tan0607/avionics-ground-station/shared/protocol/PROTOCOL.md

# Telemetry Packet Protocol

> **NOT CURRENTLY FLOWN.** The live downlink is ASCII MRCC text, decoded by
> `mrcc.py`; the firmware that speaks this binary format was removed from
> `firmware/` (see that README). This spec survives because `packet.Telemetry`
> is still the project's internal data shape — `mrcc.py` maps MRCC *onto* it, so
> loss tracking, `telemetry.csv`, the WebSocket and the dashboard all keep
> consuming one shape. Read the field table as the definition of that shape.
>
> The framing, CRC and C struct below describe a wire format nothing on either
> end currently produces or parses. They are kept for the day the binary link is
> revived, not as a description of today's hardware.
>
> `packet.py` is the source of truth; this document mirrors it in human-readable
> form. Little-endian throughout.

## Framing

Every packet is a fixed **32 bytes**:

```
+--------+--------------------+-----------+
| SYNC   | BODY               | CRC16     |
| 2 B    | 28 B               | 2 B (LE)  |
| AA 55  | (fields below)     |           |
+--------+--------------------+-----------+
  0    1  2 ................ 29  30     31
```

- **SYNC** = the two literal bytes `0xAA 0x55` (that order on the wire). Marks packet boundaries in a byte stream.
- **BODY** = 28 bytes of fields (table below).
- **CRC16** = CRC-16/CCITT-FALSE over the 28 BODY bytes only (offsets 2..29), stored little-endian.

Rate: 4 Hz nominal (~128 B/s), on a bare SX1278 at SF7 / BW 125 kHz / CR 4-5
(~72 ms on air per frame) — the settings the removed binary firmware used. The
link that actually flies runs at BW 250 kHz with hardware CRC on and carries a
52-67 byte MRCC binary frame at 10 Hz, which the ground station expands into the
ASCII `shared/protocol/mrcc.py` parses; see `firmware/README.md` for the current
parameters. That frame is NOT the format below — it is a different layout with
its own field table, specified in `MRCC_FlightComputer_A/src/Config.h`. Either
way the radio is a transport detail and does not affect the bytes below.

## Field table (BODY — offsets are relative to frame start)

| Off | Size | Field | Type | Units / scaling |
|----:|-----:|---|---|---|
| 2 | 1 | msg_type | u8 | 0 = telemetry (1/2 reserved: phase-2 command/ack)  |
| 3 | 2 | seq | u16  | +1 per packet, wraps at 65535 → drives loss rate |
| 5 | 1 | flight_state | u8 | enum (below) |
| 6 | 4 | onboard_ms | u32  | ms since flight-computer boot |
| 10  | 2 | baro_alt_m | i16  | barometric altitude, m AGL |
| 12  | 2 | vspeed_dms | i16  | vertical speed, dm/s (÷10 = m/s) |
| 14  | 4 | gps_lat | i32  | latitude, degrees × 1e7 |
| 18  | 4 | gps_lon | i32  | longitude, degrees × 1e7 |
| 22  | 2 | gps_alt_m | i16  | GPS altitude, m MSL |
| 24  | 1 | gps_sats | u8 | satellites used |
| 25  | 1 | gps_fix | u8 | 0 none / 2 = 2D / 3 = 3D |
| 26  | 1 | tilt_deg | u8 | tilt from vertical, 0..180° |
| 27  | 1 | vbat_dv | u8 | battery volts × 10 (÷10 = V) |
| 28  | 1 | flags | u8 | bitfield (below) |
| 29  | 1 | health | u8 | per-peripheral health bitfield (below) |
| 30  | 2 | crc16 | u16  | CRC-16/CCITT-FALSE over bytes 2..29 |

Python `struct` format (little-endian, no padding): BODY = `<BHBIhhiihBBBBBB` (28 bytes).

## Enums

**flight_state**

| Value | Name | Meaning |
|---:|---|---|
| 0 | PAD | on the pad, pre-launch |
| 1 | BOOST  | motor burning |
| 2 | COAST  | unpowered ascent |
| 3 | APOGEE | peak altitude |
| 4 | DROGUE | descent under drogue |
| 5 | MAIN | descent under main chute |
| 6 | LANDED | on the ground |
| 7 | ARMED  | on the pad, pyro armed |

`ARMED` is **7 and not 1** because 0–6 were already on the wire, in every
`telemetry.csv` on disk and in the PLDR notebook. Inserting it chronologically
would have silently reinterpreted every recorded flight. Chronological order is
a display concern — the dashboard's timeline carries its own.

It was missing entirely until 2026-09-04, and the cost was not a missing label:
an unmapped phase word falls back to `PAD`, so an armed vehicle reported itself
as sitting safe on the pad with its pyro bus live. `backend/tests.py` now reads
`Flight.cpp`'s `stateName()` and fails if any word it can return is unmapped.

**gps_fix**: 0 = no fix, 2 = 2D, 3 = 3D.

## flags (u8 bitfield)

| Bit | Mask | Name | Meaning |
|----:|-----:|---|---|
| 0 | 0x01 | CONTINUITY | e-match continuity OK |
| 1 | 0x02 | PYRO_FIRED | a pyro channel has fired |
| 2 | 0x04 | SD_OK | onboard SD logging healthy |
| 3 | 0x08 | ARMED | flight computer armed |
| 4–7 | — | reserved | 0 |

## health (u8 bitfield)

Bit **set** = that peripheral initialised and is currently responding.
Bit **clear** = it is not, and every field it feeds is untrustworthy.

| Bit | Mask | Name | Feeds |
|----:|-----:|---|---|
| 0 | 0x01 | BARO | `baro_alt_m`, `vspeed_dms` |
| 1 | 0x02 | IMU  | `tilt_deg` |
| 2 | 0x04 | GPS  | `gps_*` |
| 3 | 0x08 | SD | onboard logging |
| 4 | 0x10 | PYRO | continuity sense |
| 5 | 0x20 | VBAT | `vbat_dv` |
| 6–7 | — | spare | 0 |

`0x3F` = all nominal.

**Why this byte exists.** A peripheral failure must degrade *one row* on the
ground station, never the whole vehicle. The flight computer does not abort boot
when a sensor's init fails and does not stall its loop when one dies in flight —
it clears the bit, keeps transmitting at 4 Hz, and lets the operator see exactly
what is down. The removed binary firmware enforced this in `lib/Subsystem`; the
flight computer that flies today reports the same idea through MRCC's
`SD=`/`BA=`/`IM=` flags, which `mrcc.py:health_from_fields` folds back into this
byte.

There is no `LORA` bit here or on the air, and that is deliberate: the
transmitter only builds a packet when its own radio is up, so a downlinked radio
flag could never read anything but `1`. Link health is whether frames arrive at
all — `loss.py`'s job, not this byte's.

**Init failure vs in-flight failure** is read off the *first* frame of a session:
a bit clear from the very first packet never came up at all; a bit that goes
1 → 0 later died in flight. Both are recorded in the Log view.

**Distinct from `FLAG_SD_OK`.** `HEALTH_SD` = card present and mounted;
`FLAG_SD_OK` = writes are currently succeeding. A mounted card with failing
writes is `1` + `0`.

MRCC carries no such flag, and `mrcc.py` leaves it unknown rather than guessing:
one frame cannot see whether a write landed. What the vehicle sends instead is
the log's own line count (`SDL`, one packet in ten), and the ground station reads
the difference between two reports — a count that has stopped moving is that
same `1` + `0`, derived where the history is rather than asserted per frame.

**A `health` of `0x00` means "no peripherals up", not "field absent."** Decoders
reading pre-health logs should treat a missing byte as *unknown* and render it
as such — six red alarms for an old capture would be a false alarm.

## CRC-16/CCITT-FALSE

Polynomial `0x1021`, init `0xFFFF`, **no** input/output reflection, **no** final XOR.
Computed over the 28 BODY bytes (offsets 2..29); stored little-endian at 30..31.

C reference (matches `packet.crc16_ccitt` exactly):

```c
uint16_t crc16_ccitt(const uint8_t *data, size_t len) {
    uint16_t crc = 0xFFFF;
    for (size_t i = 0; i < len; i++) {
        crc ^= (uint16_t)data[i] << 8;
        for (int b = 0; b < 8; b++)
            crc = (crc & 0x8000) ? (uint16_t)((crc << 1) ^ 0x1021)
                                 : (uint16_t)(crc << 1);
    }
    return crc;
}
```

## C struct (reference)

> Nothing in `firmware/` mirrors this today; the C twin was removed with the
> binary firmware. Kept as the reference implementation for whoever revives it.

ESP32 is little-endian, so a packed struct maps straight onto the wire BODY:

```c
#pragma pack(push, 1)
typedef struct {
    uint8_t  msg_type;      // 0 = telemetry
    uint16_t seq;
    uint8_t  flight_state;
    uint32_t onboard_ms;
    int16_t  baro_alt_m;
    int16_t  vspeed_dms;    // dm/s
    int32_t  gps_lat;       // deg * 1e7
    int32_t  gps_lon;       // deg * 1e7
    int16_t  gps_alt_m;
    uint8_t  gps_sats;
    uint8_t  gps_fix;
    uint8_t  tilt_deg;
    uint8_t  vbat_dv;       // V * 10
    uint8_t  flags;
    uint8_t  health;        // HEALTH_* bitfield
} body_t;                   // sizeof == 28
#pragma pack(pop)

// wire = { 0xAA, 0x55 } ++ body_t ++ crc16_ccitt((uint8_t*)&body, 28)   // CRC little-endian
```

TX discipline: wait for the E32 **AUX pin HIGH** before every UART write (GROUND_STATION_PLAN.md §3) — never blind-write.

## CSV contract

Backend `telemetry.csv` and the PLDR notebook share one column order (`packet.CSV_COLUMNS`):

```
host_time, gps_time, onboard_ms, seq, flight_state, baro_alt_m, vspeed_ms,
gps_lat, gps_lon, gps_alt_m, gps_sats, gps_fix, tilt_deg, vbat_v,
continuity, pyro_fired, sd_ok, armed,
hw_baro, hw_imu, hw_gps, hw_sd, hw_pyro, hw_vbat
```

The `hw_*` columns are the decoded `health` bits (1 = peripheral OK), so a
post-flight analysis can tell "the altitude went flat because the baro died at
T+14" from "the rocket stopped climbing".

`host_time` = laptop receive time; `gps_time` = from GPS if present. Values are decoded engineering
units (m/s, volts, decimal degrees); booleans are 0/1. `packet.Telemetry.to_csv_row(host_time, gps_time)`
returns exactly this dict.

## SD-card log

The onboard SD log should use the **same `body_t`** (a superset with extra high-rate fields is fine),
so one Python parser handles both SD and GS data. Downlink is a 4 Hz decimated view; the SD card is the
full-rate master record.

## Using the codec (Python, from repo root)

```python
from shared.protocol import packet

frame = packet.encode(t)      # Telemetry -> 32 bytes
t = packet.decode(frame)      # 32 bytes -> Telemetry | None (checks sync + CRC)

p = packet.PacketParser()     # streaming framer for serial chunks
for t in p.feed(chunk):       # yields decoded Telemetry, resyncs past noise
    ...
print(p.crc_errors)           # count of CRC failures seen
```
