tan0607/avionics-ground-station/firmware/MRCC_FlightComputer_A/src/Storage.cpp

#include "Storage.h"
#include "Flight.h"
#include "Pyro.h"
#include "Config.h"
#include "State.h"
#include "LogCheckpoint.h"

#ifndef HSPI
#define HSPI 1
#endif

SPIClass sdSPI(HSPI);
CheckedLogFile logFile;
static LogFileSystem LogFiles;

char          logFileName[32] = "";
unsigned long logLineCount    = 0;
unsigned long sdErrorCount    = 0;
unsigned long sdCheckpointLastUs = 0;
unsigned long sdCheckpointMaxUs  = 0;
int           logFileIndex    = 0;

static LogCheckpoint logCheckpoint;

uint8_t probeResult = PROBE_NO_MODULE;

static unsigned long lastLog   = 0;
static bool cardIsHighCapacity = false;
static unsigned long sdMountHz = 0;

static void logOneLine();
static void closeLogBeforeUnmount();
static bool testMisoLine(bool verbose);
static bool testCardHandshake(bool verbose);
static void verifyWrite();
static void storageFailure(const char* reason, int ioError = 0);


// =====================================================
// STEP 1 - IS THE MODULE THERE?
//
// Force the pin low with an internal pulldown. A powered
// module's pullup wins and it still reads HIGH.
// =====================================================

static bool testMisoLine(bool verbose) {
  pinMode(SD_CS, OUTPUT);
  digitalWrite(SD_CS, HIGH);
  delay(20);

  int idlePulldown = 0;
  int idlePullup   = 0;
  int selPulldown  = 0;

  // Retry - a regulator on a marginal rail needs time
  for (int attempt = 0; attempt < 3; attempt++) {
    pinMode(SD_MISO, INPUT_PULLDOWN);
    delay(5);
    idlePulldown = digitalRead(SD_MISO);

    pinMode(SD_MISO, INPUT_PULLUP);
    delay(5);
    idlePullup = digitalRead(SD_MISO);

    digitalWrite(SD_CS, LOW);
    delay(5);
    pinMode(SD_MISO, INPUT_PULLDOWN);
    delay(5);
    selPulldown = digitalRead(SD_MISO);

    digitalWrite(SD_CS, HIGH);
    pinMode(SD_MISO, INPUT);
    delay(5);

    if (idlePulldown == 1 || selPulldown == 1) break;

    if (attempt < 2) delay(300);
  }

  if (verbose) {
    Serial.print("[SD] MISO test  idle(pd/pu)=");
    Serial.print(idlePulldown);
    Serial.print("/");
    Serial.print(idlePullup);
    Serial.print("  selected(pd)=");
    Serial.println(selPulldown);
  }

  if (idlePullup == 0) {
    if (verbose) {
      Serial.println("[SD] >>> MISO STUCK LOW - POWER FAULT <<<");
      Serial.println("[SD] Reads LOW even with the pullup on, so this");
      Serial.println("[SD] is not a loose data line or a wrong pin.");
      Serial.println("[SD] Measure VCC to GND on the module itself.");
    }
    probeResult = PROBE_MISO_LOW;
    return false;
  }

  if (idlePulldown == 1 || selPulldown == 1) {
    if (verbose) Serial.println("[SD] MODULE DETECTED");
    return true;
  }

  if (verbose) {
    Serial.println("[SD] >>> NOTHING ON MISO <<<");
    Serial.println("[SD] Module not connected, not powered,");
    Serial.println("[SD] or the MISO wire is on the wrong pin.");
  }
  probeResult = PROBE_NO_MODULE;
  return false;
}


// =====================================================
// RAW SD COMMAND
// =====================================================

static uint8_t sdCommand(uint8_t cmd, uint32_t arg, uint8_t crc) {
  sdSPI.transfer(0xFF);

  sdSPI.transfer(0x40 | cmd);
  sdSPI.transfer((uint8_t)(arg >> 24));
  sdSPI.transfer((uint8_t)(arg >> 16));
  sdSPI.transfer((uint8_t)(arg >> 8));
  sdSPI.transfer((uint8_t)(arg));
  sdSPI.transfer(crc);

  for (int i = 0; i < 10; i++) {
    uint8_t r = sdSPI.transfer(0xFF);
    if ((r & 0x80) == 0) return r;
  }

  return 0xFF;
}


// =====================================================
// STEP 2 - IS A LIVE CARD IN THE SOCKET?
//
// CMD0 proves the card exists and every SPI line is
// correct, with no filesystem involved.
// =====================================================

static bool testCardHandshake(bool verbose) {
  sdSPI.begin(SD_SCK, SD_MISO, SD_MOSI, SD_CS);

  pinMode(SD_CS, OUTPUT);
  digitalWrite(SD_CS, HIGH);

  sdSPI.beginTransaction(SPISettings(400000, MSBFIRST, SPI_MODE0));

  for (int i = 0; i < 12; i++) sdSPI.transfer(0xFF);

  uint8_t r1 = 0xFF;

  for (int attempt = 0; attempt < 8; attempt++) {
    digitalWrite(SD_CS, LOW);
    r1 = sdCommand(0, 0, 0x95);
    digitalWrite(SD_CS, HIGH);
    sdSPI.transfer(0xFF);

    if (r1 == 0x01) break;
    delay(20);
  }

  if (verbose) {
    Serial.print("[SD] CMD0 response: 0x");
    if (r1 < 0x10) Serial.print("0");
    Serial.println(r1, HEX);
  }

  if (r1 != 0x01) {
    sdSPI.endTransaction();

    if (verbose) {
      if (r1 == 0xFF) {
        Serial.println("[SD] >>> NO CARD RESPONSE <<<");
        Serial.println("[SD] Module wired, but no card answered.");
        Serial.println("[SD] Not inserted, not seated, or dead.");
      }
      else if (r1 == 0x00) {
        Serial.println("[SD] >>> MISO READS ALL ZEROS <<<");
      }
      else {
        Serial.println("[SD] >>> CARD REPLIED BUT NOT IDLE <<<");
      }
    }

    probeResult = PROBE_NO_CARD;
    return false;
  }

  // CMD8 - v1 or v2
  digitalWrite(SD_CS, LOW);
  uint8_t r8 = sdCommand(8, 0x000001AA, 0x87);

  bool isV2 = false;

  if (r8 == 0x01) {
    uint8_t b[4];
    for (int i = 0; i < 4; i++) b[i] = sdSPI.transfer(0xFF);
    isV2 = (b[3] == 0xAA);
  }

  digitalWrite(SD_CS, HIGH);
  sdSPI.transfer(0xFF);

  // ACMD41 - finish init
  uint8_t rInit  = 0xFF;
  unsigned long t0 = millis();

  while (millis() - t0 < 1500) {
    digitalWrite(SD_CS, LOW);
    sdCommand(55, 0, 0x65);
    rInit = sdCommand(41, isV2 ? 0x40000000UL : 0, 0x77);
    digitalWrite(SD_CS, HIGH);
    sdSPI.transfer(0xFF);

    if (rInit == 0x00) break;
    delay(10);
  }

  if (rInit != 0x00) {
    if (verbose) {
      Serial.println("[SD] Card found but failed ACMD41 init.");
      Serial.println("[SD] Worn out card, or a weak 3.3V supply.");
    }
    sdSPI.endTransaction();
    probeResult = PROBE_NO_CARD;
    return false;
  }

  // CMD58 - capacity class
  digitalWrite(SD_CS, LOW);
  uint8_t r58 = sdCommand(58, 0, 0xFD);

  if (r58 == 0x00) {
    uint8_t ocr0 = sdSPI.transfer(0xFF);
    sdSPI.transfer(0xFF);
    sdSPI.transfer(0xFF);
    sdSPI.transfer(0xFF);
    cardIsHighCapacity = (ocr0 & 0x40) != 0;
  }

  digitalWrite(SD_CS, HIGH);
  sdSPI.transfer(0xFF);
  sdSPI.endTransaction();

  if (verbose) {
    Serial.print("[SD] Card class: ");
    Serial.println(cardIsHighCapacity ? "SDHC / SDXC" : "SDSC");
    Serial.println("[SD] *** HARDWARE OK ***");
  }

  probeResult = PROBE_CARD_OK;
  return true;
}


// =====================================================
// INIT
// =====================================================

bool initSD(bool verbose) {
  if (verbose) {
    Serial.println();
    Serial.println("--------- SD DIAGNOSTIC ---------");
    Serial.print("[SD] Pins  CS=");
    Serial.print(SD_CS);
    Serial.print("  SCK=");
    Serial.print(SD_SCK);
    Serial.print("  MOSI=");
    Serial.print(SD_MOSI);
    Serial.print("  MISO=");
    Serial.println(SD_MISO);
  }

  // Before the probe below unmounts the card. See closeLogBeforeUnmount().
  closeLogBeforeUnmount();

  sdOK = false;

  if (!testMisoLine(verbose))      { if (verbose) printSdHelp(); return false; }
  if (!testCardHandshake(verbose)) { if (verbose) printSdHelp(); return false; }

  if (verbose) Serial.println("[SD] Mounting filesystem...");

  SD.end();
  delay(50);

  // 4 MHz first, not 10. A marginal rail or long wiring mounts happily at
  // 10 MHz and then loses the card during sustained writes, which the driver
  // reports much later as a descriptor that is no longer valid.
  sdMountHz = 4000000;
  sdOK = SD.begin(SD_CS, sdSPI, sdMountHz);

  if (!sdOK) {
    sdMountHz = 1000000;
    sdOK = SD.begin(SD_CS, sdSPI, sdMountHz);
  }

  if (!sdOK) {
    sdMountHz = 0;
    if (verbose) {
      Serial.println("[SD] >>> CARD ALIVE BUT NO USABLE FILESYSTEM <<<");
      Serial.println("[SD] It is exFAT, blank or corrupted.");
      Serial.println("[SD] Send  F  to format it here - no reader needed.");
    }
    return false;
  }

  if (verbose) {
    Serial.print("[SD] Mounted at ");
    Serial.print(sdMountHz / 1000000.0, 1);
    Serial.println(" MHz");

    uint8_t cardType = SD.cardType();

    Serial.print("[SD] Card type: ");
    if (cardType == CARD_MMC)       Serial.println("MMC");
    else if (cardType == CARD_SD)   Serial.println("SDSC");
    else if (cardType == CARD_SDHC) Serial.println("SDHC");
    else                            Serial.println("UNKNOWN");

    Serial.print("[SD] Card size: ");
    Serial.print((unsigned long)(SD.cardSize() / (1024ULL * 1024ULL)));
    Serial.println(" MB");
  }

  startNewLogFile();
  return sdOK;
}


// =====================================================
// LOG FILE
// =====================================================

void startNewLogFile() {
  if (!sdOK) return;

  if (logFile.isOpen()) {
    flushSD();
    if (!sdOK) return;
    logFile.close();
  }

  for (int i = 1; i < 1000; i++) {
    snprintf(logFileName, sizeof(logFileName), "/FLIGHT%03d.CSV", i);
    // Set with the name, not after the loop, so the two cannot disagree -
    // including on the exhausted-card path, where the loop runs out rather
    // than breaking and the name stays at the last one it built.
    logFileIndex = i;
    if (!SD.exists(logFileName)) break;
  }

  Serial.print("[SD] Log file: ");
  Serial.println(logFileName);

  logFile = LogFiles.open(logFileName, FILE_WRITE);

  if (!logFile) {
    Serial.println("[SD] ERROR - cannot create file");
    sdOK = false;
    return;
  }

  // ST is the numeric flight state (see Flight.h):
  // 0 PAD 1 ARMED 2 BOOST 3 COAST 4 APOGEE 5 DESCENT 6 LANDED
  logFile.println(
    "PKT,T,GD,GF,SAT,LAT,LON,GA,GS,CRS,"
    "AX,AY,AZ,GX,GY,GZ,MX,MY,MZ,VX,VY,HDG,VB,BOOT,"
    "ST,ALT,VZ,MAXALT,PRS,BTEMP,ARM,FIR,"
    // ALT is AGL, measured against GREF. Without GREF in the file
    // there is no way back to MSL after the flight, and no way to
    // tell a pad that moved (weather drift) from a rocket that did.
    "GREF,"
    // Filtered twins. Every column from here on has a raw
    // counterpart above it, so one flight gives you both
    // the before and the after with nothing to line up.
    "FAX,FAY,FAZ,FGX,FGY,FGZ,FMX,FMY,FMZ,"
    "ANRM,FANRM,RA,PA,RL,PL,RC,PC,RK,PK,FHDG,ATR,IHZ"
  );

  // Marker so you can see across files whether the
  // board restarted, and why
  logFile.print("# BOOT=");
  logFile.print(bootCount);
  logFile.print(" RESET=");
  logFile.println(resetReasonName);

  if (!logFile.flush()) { storageFailure("header write/fsync", logFile.errorNumber()); return; }
  if (!logFile.close()) { storageFailure("header close", logFile.errorNumber()); return; }

  logLineCount = 0;
  sdErrorCount = 0;
  sdCheckpointLastUs = sdCheckpointMaxUs = 0;

  verifyWrite();
  if (!sdOK) { sdErrorCount++; return; }

  logFile = LogFiles.open(logFileName, FILE_APPEND);

  if (!logFile) {
    Serial.println("[SD] ERROR - cannot reopen for append");
    sdErrorCount++;
    sdOK = false;
  }
}


static void verifyWrite() {
  CheckedLogFile f = LogFiles.open(logFileName, FILE_READ);

  if (!f) {
    Serial.print("[SD] VERIFY FAILED - cannot reopen | io_errno=");
    Serial.println(f.errorNumber());
    sdOK = false;
    return;
  }

  uint8_t prefix[8];
  int received = f.read(prefix, sizeof(prefix));
  size_t sizeOnCard = 0;
  bool sized = f.querySize(sizeOnCard);
  bool closed = f.close();
  if (!sized) {
    Serial.print("[SD] VERIFY FAILED - cannot size the file | io_errno=");
    Serial.println(f.statErrorNumber());
    sdOK = false; return;
  }
  if (!closed || f.errorNumber()) {
    Serial.print("[SD] VERIFY FAILED - header read/close | io_errno=");
    Serial.println(f.errorNumber());
    sdOK = false; return;
  }

  Serial.print("[SD] Read back ");
  Serial.print(static_cast<unsigned long>(sizeOnCard));
  Serial.println(" bytes from the card");

  if (received == 8 && memcmp(prefix, "PKT,T,GD", 8) == 0) {
    logCheckpoint.reset(sizeOnCard);
    Serial.println("[SD] *** HEADER VERIFIED - data verified at each checkpoint ***");
  }
  else {
    Serial.println("[SD] VERIFY FAILED - data did not match");
    sdOK = false;
  }
}


// =====================================================
// LOGGING - fixed 10 Hz, drift free
// =====================================================

static void storageFailure(const char* reason, int ioError) {
  sdErrorCount++;
  sdOK = false;
  // Unconditional: this runs precisely when the handle has just failed, and a
  // descriptor left open here is one the next remount would strand for good.
  logFile.close();
  Serial.print("[SD] CHECKPOINT/WRITE FAILED: ");
  Serial.print(reason);
  Serial.print(" | verified lines=");
  Serial.print(logLineCount);
  Serial.print(" | file=");
  Serial.print(logFileName);
  Serial.print(" | base=");
  Serial.print(static_cast<unsigned long>(logCheckpoint.committedBytes()));
  Serial.print(" expected=");
  Serial.print(static_cast<unsigned long>(logCheckpoint.expectedBytes()));
  Serial.print(" actual=");
  if (logCheckpoint.readbackSizeKnown()) {
    Serial.print(static_cast<unsigned long>(logCheckpoint.readbackBytes()));
  } else {
    Serial.print("unknown");
  }
  Serial.print(" pending=");
  Serial.print(logCheckpoint.pendingLines());
  Serial.print(" | io_errno=");
  Serial.print(ioError);
  // Traced to the instruction in the shipped binary: FatFs validate() returns
  // FR_INVALID_OBJECT when the driver reports the card uninitialised, and the
  // VFS maps that to EBADF. It means the card stopped answering, not that this
  // row was too long or the handle was misused.
  if (ioError == EBADF) Serial.print(" (EBADF - card stopped answering)");
  Serial.print(" | mount=");
  Serial.print(sdMountHz / 1000000.0, 1);
  Serial.print("MHz | t=");
  Serial.print(millis());
  Serial.println("ms");
}

void serviceLogging() {
  if (millis() - lastLog < LOG_INTERVAL) return;

  lastLog += LOG_INTERVAL;

  // More than 4 intervals behind - stop trying to catch up
  if (millis() - lastLog >= LOG_INTERVAL * 4) {
    lastLog = millis();
  }

  logOneLine();
}


static void logOneLine() {
  if (!sdOK || !logFile.isOpen()) return;

  char line[512];

  int len = snprintf(
    line, sizeof(line),
    "%lu,%.2f,%d,%d,%d,%.6f,%.6f,%.1f,%.2f,%.0f,"
    "%.2f,%.2f,%.2f,%.1f,%.1f,%.1f,%.1f,%.1f,%.1f,%.2f,%.2f,%.0f,%.2f,%lu,"
    "%d,%.2f,%.2f,%.2f,%.2f,%.1f,%d,%d,%.2f,"
    "%.2f,%.2f,%.2f,%.1f,%.1f,%.1f,%.1f,%.1f,%.1f,"
    "%.2f,%.2f,%.1f,%.1f,%.1f,%.1f,%.1f,%.1f,%.1f,%.1f,%.0f,%d,%.0f",
    packetNumber, millis() / 1000.0,
    gpsData ? 1 : 0, gpsFix ? 1 : 0, satellites,
    latitude, longitude, gpsAltitude, gpsSpeed, gpsCourse,
    ax, ay, az, gx, gy, gz, mx, my, mz,
    vx, vy, heading, vbat, bootCount,
    flightState, altFiltered, vertVel, maxAlt, pressure, baroTemp,
    pyroArmed ? 1 : 0, pyroFired ? 1 : 0, groundAlt,
    fax, fay, faz, fgx, fgy, fgz, fmx, fmy, fmz,
    accelNormRaw, accelNormFilt,
    rollAcc, pitchAcc, rollLpf, pitchLpf,
    rollComp, pitchComp, rollKal, pitchKal,
    headingFilt, accelTrusted ? 1 : 0, imuHz
  );

  if (len <= 0 || len >= (int)sizeof(line)) {
    sdErrorCount++;
    return;
  }

  if (!logCheckpoint.append(logFile, line, static_cast<size_t>(len))) {
    storageFailure(logCheckpoint.error(), logCheckpoint.ioErrorNumber());
  }
}


void flushSD() {
  if (!sdOK || !logFile.isOpen() || !logCheckpoint.pending()) return;
  unsigned long started = micros();
  bool ok = logCheckpoint.commit(logFile, LogFiles, logFileName);
  sdCheckpointLastUs = micros() - started;
  if (sdCheckpointLastUs > sdCheckpointMaxUs) sdCheckpointMaxUs = sdCheckpointLastUs;
  if (!ok) {
    storageFailure(logCheckpoint.error(), logCheckpoint.ioErrorNumber());
    return;
  }
  // Only readback-verified rows are reported to serial and SDF/SDL/SDE.
  logLineCount = logCheckpoint.verifiedLines();
}


// SD.end() unregisters the /sd VFS. A descriptor still open across it becomes
// permanently invalid - every later write, fsync and close returns EBADF, and
// the card never sees the row. Anything that remounts calls this first.
static void closeLogBeforeUnmount() {
  if (sdOK) flushSD();   // best effort while the mount is still live
  logFile.close();
}


// =====================================================
// DUMP - read the card back over serial.
// This is how you recover data with no card reader.
// =====================================================

void dumpLogFile() {
  if (!sdOK) {
    Serial.println("[SD] OFFLINE - nothing to dump");
    return;
  }

  if (logFile.isOpen()) {
    flushSD();
    if (!sdOK) return;
    logFile.close();
  }

  File f = SD.open(logFileName, FILE_READ);

  if (!f) {
    Serial.println("[SD] ERROR - cannot open for reading");
    return;
  }

  Serial.println();
  Serial.println("=========== BEGIN FILE DUMP ===========");
  Serial.print("FILE: ");
  Serial.println(logFileName);
  Serial.print("SIZE: ");
  Serial.print(f.size());
  Serial.println(" bytes");
  Serial.println("---------------------------------------");

  uint8_t buf[256];

  while (f.available()) {
    int n = f.read(buf, sizeof(buf));
    Serial.write(buf, n);
  }

  f.close();

  Serial.println();
  Serial.println("============ END FILE DUMP ============");
  Serial.println();

  logFile = LogFiles.open(logFileName, FILE_APPEND);
  if (!logFile) storageFailure("dump append reopen", logFile.errorNumber());
}


void listFiles() {
  if (!sdOK) {
    Serial.println("[SD] OFFLINE");
    return;
  }

  flushSD();
  if (!sdOK) return;

  File root = SD.open("/");

  if (!root) {
    Serial.println("[SD] ERROR - cannot open root");
    return;
  }

  Serial.println();
  Serial.println("---------- FILES ON CARD ----------");

  File entry = root.openNextFile();

  while (entry) {
    Serial.print(entry.isDirectory() ? "[DIR ] " : "[FILE] ");
    Serial.print(entry.name());
    Serial.print("  ");
    Serial.print(entry.size());
    Serial.println(" bytes");

    entry.close();
    entry = root.openNextFile();
  }

  root.close();
  Serial.println("-----------------------------------");
  Serial.println();
}


// =====================================================
// FORMAT ON BOARD - for when you have no card reader
// =====================================================

void formatCard() {
  Serial.println();
  Serial.println("[SD] ===== FORMAT CARD =====");

  if (probeResult != PROBE_CARD_OK) {
    Serial.println("[SD] No live card. Fix the hardware first.");
    Serial.println("[SD] Send  I  to re-test.");
    return;
  }

  Serial.println("[SD] THIS ERASES EVERYTHING.");
  Serial.println("[SD] Send  Y  within 10 seconds to confirm.");

  unsigned long t0 = millis();
  bool confirmed   = false;

  while (millis() - t0 < 10000) {
    if (Serial.available() > 0) {
      char c = Serial.read();
      if (c == 'y' || c == 'Y') { confirmed = true; break; }
      if (c != '\n' && c != '\r') break;
    }
    delay(10);
  }

  if (!confirmed) {
    Serial.println("[SD] Format cancelled.");
    return;
  }

  Serial.println("[SD] Formatting... do not unplug.");

  closeLogBeforeUnmount();

  SD.end();
  delay(200);

  sdOK = SD.begin(SD_CS, sdSPI, 4000000, "/sd", 5, true);

  if (!sdOK) {
    Serial.println("[SD] FORMAT FAILED. Try a 32 GB or smaller card.");
    return;
  }

  Serial.println("[SD] *** FORMAT SUCCESSFUL ***");
  startNewLogFile();
}


void printSdHelp() {
  Serial.println("[SD] ---- CHECK THIS ----");
  Serial.println("[SD] 1. POWER: modules with a regulator chip need");
  Serial.println("[SD]    5V on VCC. Bare adapters need 3.3V.");
  Serial.println("[SD] 2. Wiring:");
  Serial.print  ("[SD]      CS   -> GPIO"); Serial.println(SD_CS);
  Serial.print  ("[SD]      SCK  -> GPIO"); Serial.println(SD_SCK);
  Serial.print  ("[SD]      MOSI -> GPIO"); Serial.println(SD_MOSI);
  Serial.print  ("[SD]      MISO -> GPIO"); Serial.println(SD_MISO);
  Serial.println("[SD]      GND  -> GND (must share GND)");
  Serial.println("[SD] 3. MISO and MOSI are the pair people swap most.");
  Serial.println("[SD] 4. Push the card until it clicks.");
  Serial.println("[SD] Fix it, then send  I  to re-test. No reflash.");
  Serial.println("[SD] FLIGHT CONTINUES WITHOUT LOGGING.");
  Serial.println("---------------------------------");
}
