tan0607/avionics-ground-station/firmware/MRCC_FlightComputer_A/src/Health.cpp

#include "Health.h"
#include "Config.h"
#include "State.h"
#include "Sensors.h"
#include "Storage.h"
#include "Radio.h"
#include "Filters.h"
#include "Baro.h"
#include "Flight.h"
#include "Pyro.h"
#include "esp_system.h"

static unsigned long lastHealthCheck = 0;
static unsigned long lastSdRetry     = 0;

// What the log last told the operator about the IMU. readIMU()
// raises imuOK the instant a sample lands, with no output; this is
// what turns that into exactly one RECOVERED line.
//
// Seeded from the boot state on the first pass, because setup()'s
// READY banner is already the announcement for whatever the IMU was
// doing then - a healthy board must not report a recovery it never
// needed, and one whose sensor only turned up late must.
static bool imuAnnounced   = false;
static bool imuAnnouncedOK = false;

static unsigned long lastRateLines = 0;
static unsigned long lastRateTime  = 0;


// =====================================================
// WHY DID THE BOARD RESTART?
// =====================================================

void reportResetReason() {
  esp_reset_reason_t reason = esp_reset_reason();

  bootCount++;

  switch (reason) {
    case ESP_RST_POWERON:   resetReasonName = "POWER ON (clean start)"; break;
    case ESP_RST_EXT:       resetReasonName = "EXTERNAL RESET BUTTON";  break;
    case ESP_RST_SW:        resetReasonName = "SOFTWARE RESET";         break;
    case ESP_RST_PANIC:     resetReasonName = "CRASH / PANIC";          break;
    case ESP_RST_INT_WDT:   resetReasonName = "INTERRUPT WATCHDOG";     break;
    case ESP_RST_TASK_WDT:  resetReasonName = "TASK WATCHDOG";          break;
    case ESP_RST_WDT:       resetReasonName = "WATCHDOG";               break;
    case ESP_RST_BROWNOUT:  resetReasonName = "BROWNOUT - SUPPLY DIPPED"; break;
    case ESP_RST_DEEPSLEEP: resetReasonName = "DEEP SLEEP WAKE";        break;
    default:                resetReasonName = "UNKNOWN";                break;
  }

  if (reason == ESP_RST_BROWNOUT) brownoutCount++;

  Serial.println();
  Serial.println("--------- RESET REASON ---------");
  Serial.print("[SYS] Boot #");
  Serial.println(bootCount);
  Serial.print("[SYS] Last reset: ");
  Serial.println(resetReasonName);

  if (reason == ESP_RST_BROWNOUT) {
    Serial.println("[SYS] >>> THE SUPPLY VOLTAGE COLLAPSED <<<");
    Serial.println("[SYS] Under vibration this is a POWER CONNECTION");
    Serial.println("[SYS] breaking contact, not an SD or code fault.");
  }

  if (brownoutCount > 0) {
    Serial.print("[SYS] Brownouts since power up: ");
    Serial.println(brownoutCount);
  }

  if (bootCount == 1 && reason != ESP_RST_POWERON) {
    Serial.println("[SYS] RTC memory was cleared - the board lost");
    Serial.println("[SYS] power COMPLETELY, not just a dip.");
  }

  Serial.println("--------------------------------");
}


// =====================================================
// RECOVERY
//
// Runs every 5 s. Marks stale subsystems down and tries
// to bring failed ones back. Retries are silent - only
// a change of state is announced, so a permanently
// missing sensor never floods the log.
// =====================================================

void serviceHealth() {
  if (millis() - lastHealthCheck < HEALTH_INTERVAL) return;
  lastHealthCheck = millis();

  // ---- IMU ----
  // imuOK means SAMPLES ARE ARRIVING. It does not mean the chip
  // answers on I2C, and the difference is the whole point of this
  // block: an ICM whose data path has stopped still acknowledges
  // begin() and every config write, quite happily, forever.
  //
  // This used to recover on initIMU() alone, and initIMU() used to
  // stamp lastImuUpdate. So a sensor delivering nothing was handed
  // both a clean bill of health and a fresh staleness clock every
  // 5 s, and printed
  //
  //     [IMU] No data for 2 s - marking DOWN
  //     [IMU] *** RECOVERED *** (recovery #41)
  //
  // back to back, forever, while the [SYS] line above and the
  // downlink both read IMU=OK. A flapping recovery counter was the
  // only tell, and it also reset the filter chain every 5 s.
  //
  // Now this block only ever takes the IMU DOWN and re-opens the
  // chip. readIMU() puts it back up, because readIMU() is the only
  // code that ever sees an actual sample.
  if (!imuAnnounced) {
    imuAnnounced   = true;
    imuAnnouncedOK = imuOK;
  }

  if (imuOK && millis() - lastImuUpdate > IMU_STALE) {
    Serial.println("[IMU] No data for 2 s - marking DOWN");
    imuOK = false;
    imuAnnouncedOK = false;
  }

  // Re-opening a wedged chip is worth a try; claiming it worked is
  // not this function's call to make.
  if (!imuOK) initIMU(false);

  // readIMU() has since seen real data. The flight logic already
  // acted on that the moment it happened - this is only the log
  // line and the pad-only gyro re-zero catching up.
  if (imuOK && !imuAnnouncedOK) {
    imuAnnouncedOK = true;
    imuRecoveries++;
    Serial.print("[IMU] *** RECOVERED *** (recovery #");
    Serial.print(imuRecoveries);
    Serial.println(")");

    // An IMU that was missing at boot never got a zero-rate
    // measurement. Take it now if the board is still on the pad.
    // Once flying, a moving airframe rejects its own samples anyway.
    if (!gyroCalDone && !gyroCalibrating()) startGyroCal();
  }

  // ---- BARO ----
  // The apogee sensor. Losing it downgrades deployment
  // to a timer, so its state changes are announced.
  if (baroOK && millis() - lastBaroUpdate > BARO_STALE) {
    Serial.println("[BARO] No data for 1 s - marking DOWN");
    Serial.println("[BARO] *** APOGEE IS NOW TIMER ONLY ***");
    baroOK = false;
  }

  if (!baroOK) {
    if (initBaro(false)) {
      baroOK = true;
      baroRecoveries++;
      Serial.print("[BARO] *** RECOVERED *** (recovery #");
      Serial.print(baroRecoveries);
      Serial.println(")");
    }
  }

  // ---- RADIO ----
  if (!radioOK) {
    if (initRadio(false)) {
      radioOK = true;
      radioRecoveries++;
      Serial.print("[LORA] *** RECOVERED *** (recovery #");
      Serial.print(radioRecoveries);
      Serial.println(")");
    }
  }

  // ---- SD ----
  // Retried less often because a full probe is slow.
  if (!sdOK && millis() - lastSdRetry > 30000) {
    lastSdRetry = millis();

    // First recovery prints the full electrical probe: MISO, card handshake and
    // card class. That says whether the card is dead or merely dropped, and it
    // costs nothing - initSD() runs the same probe either way, verbose only
    // decides whether the result is printed.
    if (initSD(sdRecoveries == 0)) {
      sdOK = true;
      sdRecoveries++;
      Serial.print("[SD] *** RECOVERED *** (recovery #");
      Serial.print(sdRecoveries);
      Serial.print(") -> ");
      Serial.println(logFileName);
    }
  }

  // ---- GPS ----
  gpsOK = (millis() - lastGpsDataTime < GPS_STALE);
}


// =====================================================
// STATUS LINE
// =====================================================

void printStatus() {
  flushSD(); // same checked checkpoint as unattended logging
  unsigned long now = millis();
  unsigned long dt  = now - lastRateTime;

  float logHz  = 0.0;
  float loopHz = 0.0;

  if (dt > 0) {
    logHz  = (logLineCount - lastRateLines) * 1000.0 / dt;
    loopHz = loopCount * 1000.0 / dt;
  }

  lastRateLines = logLineCount;
  lastRateTime  = now;
  loopCount     = 0;

  // The flight line goes first. On the pad this is the
  // only line anyone actually reads.
  Serial.print("[FLT] ");
  Serial.print(stateName(flightState));
  Serial.print(" | pyro=");
  Serial.print(pyroArmed ? "ARMED" : "safe");

  if (pyroFired) {
    Serial.print(" FIRED(");
    Serial.print(lastFireReason);
    Serial.print(")");
  }

#if PYRO_CONT_ENABLED
  Serial.print(" | cont=");
  Serial.print(contOK ? "OK" : "OPEN");
#endif

  if (baroOK) {
    Serial.print(" | alt=");
    Serial.print(altFiltered, 1);
    Serial.print("m v=");
    Serial.print(vertVel, 1);
    Serial.print("m/s max=");
    Serial.print(maxAlt, 1);
    // What alt is measured FROM. On the pad alt should read ~0 and
    // this should read the site elevation for the day's pressure; if
    // alt is sitting at some odd number instead, this line says
    // whether the reference is wrong or the sensor is.
    Serial.print("m ref=");
    Serial.print(groundAlt, 1);
    Serial.print("m");

    // Only when it has happened. On a clean board this line never
    // appears, so its presence is the whole message.
    //
    // This block used to sit OUTSIDE the baroOK test, and the else
    // below was therefore paired with the spike count rather than
    // with the sensor. Both halves were inverted by it: a healthy
    // board with zero spikes printed "NO BARO - apogee would be
    // TIMER ONLY" on every status line, and a board that HAD spiked
    // never printed that warning at all - not even with the
    // barometer genuinely down. The one line an operator must be
    // able to trust on the pad cried wolf whenever it was fine and
    // stayed quiet when it was not.
    if (baroSpikeCount > 0) {
      Serial.print(" | SPIKES=");
      Serial.print(baroSpikeCount);
      Serial.print(" last=");
      Serial.print(baroSpikeAlt, 0);
      Serial.print("m");
    }

    // A different fault from a spike: the sensor is not refusing a
    // reading, it is refusing the trigger. Baro.cpp stops publishing
    // when this happens rather than re-serving the last conversion,
    // so a climbing count with a healthy-looking altitude means the
    // altitude is about to go stale, not that it is wrong.
    if (baroTriggerFails > 0) {
      Serial.print(" | TRIG_FAIL=");
      Serial.print(baroTriggerFails);
    }
    // A non-zero count here is the supply, not the sensor. The part answers
    // fine either side of it; what it cannot do is hold a register.
    if (baroConfigLost > 0) {
      Serial.print(" | RESET=");
      Serial.print(baroConfigLost);
    }
  }
  else {
    Serial.print(" | NO BARO - apogee would be TIMER ONLY");
  }

  if (flightState == FS_PAD && imuOK) {
    Serial.print(" | a=");
    Serial.print(accelMag, 2);
    Serial.print(" g=");
    Serial.print(gyroMag, 1);
  }

  Serial.println();

  printArmReadiness();

  // Subsystem health next - one glance tells you what is alive
  Serial.print("[SYS] IMU=");
  Serial.print(imuOK   ? "OK"   : "DOWN");
  Serial.print(" GPS=");
  Serial.print(gpsOK   ? "OK"   : "DOWN");
  Serial.print(" LORA=");
  Serial.print(radioOK ? "OK"   : "DOWN");
  Serial.print(" SD=");
  Serial.print(sdOK    ? "OK"   : "DOWN");
  Serial.print(" BARO=");
  Serial.print(baroOK  ? "OK"   : "DOWN");
  Serial.print(" | boot=");
  Serial.print(bootCount);
  Serial.print(" | loop=");
  Serial.print(loopHz, 0);
  Serial.print("Hz");

#if VBAT_ENABLED
  Serial.print(" | V=");
  Serial.print(vbat, 2);
  Serial.print(" min=");
  Serial.print(vbatMin, 2);
#endif

  if (brownoutCount > 0) {
    Serial.print(" | BROWNOUTS=");
    Serial.print(brownoutCount);
  }

  if (imuRecoveries || radioRecoveries || sdRecoveries || baroRecoveries) {
    Serial.print(" | recovered I:");
    Serial.print(imuRecoveries);
    Serial.print(" L:");
    Serial.print(radioRecoveries);
    Serial.print(" S:");
    Serial.print(sdRecoveries);
    Serial.print(" B:");
    Serial.print(baroRecoveries);
  }

  Serial.println();

  if (imuOK) printFilterStatus();

  if (sdOK && logFile.isOpen()) {
    Serial.print("[SD]  ");
    Serial.print(logFileName);
    Serial.print(" | lines=");
    Serial.print(logLineCount);
    // Reporting only: querySize() cannot mark the log failed, so a card that
    // stops answering shows up in this field instead of stopping the log.
    Serial.print(" | bytes=");
    size_t bytesOnCard = 0;
    if (logFile.querySize(bytesOnCard)) {
      Serial.print(static_cast<unsigned long>(bytesOnCard));
    } else {
      Serial.print("? io_errno=");
      Serial.print(logFile.statErrorNumber());
    }
    Serial.print(" | rate=");
    Serial.print(logHz, 1);
    Serial.print("Hz | err=");
    Serial.print(sdErrorCount);
    Serial.print(" | checkpoint=");
    Serial.print(sdCheckpointLastUs / 1000.0, 1);
    Serial.print("ms max=");
    Serial.print(sdCheckpointMaxUs / 1000.0, 1);
    Serial.println("ms");
  }

  if (txBusyCount || txTimeoutCount || txFallbackCount) {
    Serial.print("[TX]  busy=");
    Serial.print(txBusyCount);
    Serial.print(" timeout=");
    Serial.print(txTimeoutCount);
    Serial.print(" noIrq=");
    Serial.println(txFallbackCount);
  }
}
