tan0607/avionics-ground-station/firmware/MRCC_FlightComputer_A/src/Radio.h

#pragma once
#include <Arduino.h>

// =====================================================
// RADIO - LoRa init and non-blocking transmit
//
// The loop is never blocked waiting for air time. A
// dead radio is skipped, not fatal.
// =====================================================

extern int  txPower;      // dBm, 2..17
extern int  txCopies;     // 1 or 2 copies per packet
extern bool showPacket;   // print full packet contents

extern unsigned long lastAirTime;
extern unsigned long txBusyCount;
extern unsigned long txTimeoutCount;
extern unsigned long txFallbackCount;

extern uint8_t txPacket[256];  // binary; 255 = LoRa's payload limit
extern int  txPacketLen;

bool initRadio(bool verbose);
void serviceTelemetry();
void applyTxPower();
