tan0607/avionics-ground-station/backend/tests.py

"""Offline self-tests for the backend's pure logic (no server, no sockets).

Run from the repo root:  backend/.venv/bin/python -m backend.tests
Covers the bits a browser smoke-test wouldn't clearly exercise: loss math across
the uint16 wrap, the exact wire-key contract, and raw.log record framing.
"""
from __future__ import annotations

import json
import re
import struct
import tempfile
import time
from pathlib import Path

from shared.protocol import mrcc, packet
from shared.protocol.packet import FLAG_ARMED, FLAG_CONTINUITY, FlightState, GpsFix

from .loss import LossTracker
from .session import (
    PACKET_DESC,
    MissionDeriver,
    SessionWriter,
    _RAW_HEADER,
    recorded_flight_detail,
    FlightFolderNotEmpty,
    delete_recorded_flight,
    event_label,
    file_snapshot,
    recorded_flights,
    resolve_recorded_flight_dir,
    resolve_recorded_flight_file,
    slugify,
)
from .sources import ReplaySource
from .wire import WIRE_KEYS, telemetry_to_wire


def test_loss_perfect_sequence() -> None:
    lt = LossTracker()
    for seq in range(1, 101):
        assert lt.observe(seq) == 0
    assert lt.lost == 0 and lt.received == 100 and lt.fraction == 0.0


def test_loss_single_gap() -> None:
    lt = LossTracker()
    lt.observe(10)
    missing = lt.observe(13)          # 11, 12 lost
    assert missing == 2 and lt.lost == 2
    assert lt.expected == 4 and abs(lt.fraction - 0.5) < 1e-9


def test_loss_wraparound() -> None:
    lt = LossTracker()
    lt.observe(65534)
    assert lt.observe(65535) == 0
    assert lt.observe(0) == 0          # 65535 -> 0 is a clean +1 across the wrap
    assert lt.observe(2) == 1          # dropped seq 1
    assert lt.lost == 1


def test_loss_reset_on_huge_jump() -> None:
    lt = LossTracker()
    lt.observe(5000)
    lt.observe(10)                     # backward-looking jump = restart, not 60k lost
    assert lt.lost == 0 and lt.resets == 1


def test_loss_duplicate() -> None:
    lt = LossTracker()
    lt.observe(42)
    assert lt.observe(42) == 0
    assert lt.duplicates == 1 and lt.lost == 0


def test_wire_contract() -> None:
    # Wire keys must exactly match the dashboard WireFrame field set.
    assert set(WIRE_KEYS) == {
        "host_time", "seq", "flight_state", "onboard_ms", "baro_alt_m", "vspeed_ms",
        "gps_lat", "gps_lon", "gps_alt_m", "gps_sats", "gps_fix", "tilt_deg",
        "vbat_v", "continuity", "pyro_fired", "sd_ok", "armed", "flags_known",
        "health", "health_known", "failed_subsystems",
        "hw_baro", "hw_imu", "hw_gps", "hw_sd", "hw_pyro", "hw_vbat",
        "rssi_dbm", "snr_db", "extra",
    }
    t = packet.Telemetry(
        seq=7, flight_state=FlightState.BOOST, onboard_ms=5000,
        baro_alt_m=1247, vspeed_dms=1420,
        gps_lat=40_986_000, gps_lon=1_009_505_000, gps_alt_m=1300,
        gps_sats=11, gps_fix=GpsFix.FIX_3D, tilt_deg=4, vbat_dv=79,
        flags=FLAG_CONTINUITY | FLAG_ARMED,
        health=packet.HEALTH_ALL_OK,
    )
    w = telemetry_to_wire(t, host_time_ms=1_700_000_000_000)
    assert set(w) == set(WIRE_KEYS)
    assert w["host_time"] == 1_700_000_000_000
    assert w["flight_state"] == 1 and isinstance(w["flight_state"], int)
    assert abs(w["vspeed_ms"] - 142.0) < 1e-9      # 1420 dm/s
    assert abs(w["vbat_v"] - 7.9) < 1e-9           # 79 * 0.1V
    assert abs(w["gps_lat"] - 4.0986) < 1e-6       # deg*1e7 -> deg
    assert abs(w["gps_lon"] - 100.9505) < 1e-6
    assert w["continuity"] is True and w["armed"] is True
    assert w["pyro_fired"] is False and w["sd_ok"] is False
    # All peripherals nominal -> every hw_* true, nothing named as failed.
    assert w["failed_subsystems"] == [] and w["health"] == packet.HEALTH_ALL_OK
    assert all(w[col] is True for _, _, col in packet.SUBSYSTEMS)

    # A dead barometer must degrade exactly ONE row and NAME it -- the whole
    # point of the health byte is that the operator never sees "AV FAILED".
    t.health = packet.HEALTH_ALL_OK & ~packet.HEALTH_BARO
    w = telemetry_to_wire(t, host_time_ms=1_700_000_000_000)
    assert w["failed_subsystems"] == ["BARO"], w["failed_subsystems"]
    assert w["hw_baro"] is False
    assert all(w[col] is True for mask, _, col in packet.SUBSYSTEMS
               if mask != packet.HEALTH_BARO)


def test_wire_partial_health_is_null_not_false() -> None:
    """A source that only knows SOME peripherals must not report the rest as
    failed. This is the difference between an operator seeing three unknowns and
    seeing three alarms for hardware nobody asked about."""
    t = packet.Telemetry(seq=1, health=packet.HEALTH_BARO | packet.HEALTH_GPS)
    known = packet.HEALTH_BARO | packet.HEALTH_IMU | packet.HEALTH_GPS
    w = telemetry_to_wire(t, host_time_ms=1_700_000_000_000, health_known=known)

    assert w["hw_baro"] is True and w["hw_gps"] is True
    assert w["hw_imu"] is False            # known, and known to be down
    assert w["hw_sd"] is None              # not known — must be null, not false
    assert w["hw_pyro"] is None and w["hw_vbat"] is None
    assert w["failed_subsystems"] == ["IMU"], w["failed_subsystems"]
    assert w["health_known"] == known

    # Default (binary frames) is unchanged: every bit reported, nothing null.
    w = telemetry_to_wire(t, host_time_ms=1_700_000_000_000)
    assert w["health_known"] == packet.HEALTH_ALL_OK
    assert w["hw_sd"] is False
    assert set(w["failed_subsystems"]) == {"IMU", "SD", "PYRO", "VBAT"}


def test_wire_unreported_flags_do_not_become_alarms() -> None:
    """A downlink carrying no flags at all (MRCC) reports flags_known == 0. That
    must not surface as OPEN continuity + FAILED SD — the safety panel is the one
    place a fabricated alarm is most expensive."""
    t = packet.Telemetry(seq=1, flags=0, health=packet.HEALTH_BARO)
    w = telemetry_to_wire(t, host_time_ms=1_700_000_000_000,
                          health_known=packet.HEALTH_BARO, flags_known=0)
    assert w["flags_known"] == 0
    # The booleans stay false; `flags_known` is what tells the UI to ignore them.
    assert w["continuity"] is False and w["sd_ok"] is False
    # No battery reading was taken -> null, never 0.0 V.
    assert w["vbat_v"] is None

    row = t.to_csv_row("x", health_known=packet.HEALTH_BARO, flags_known=0)
    assert row["continuity"] == "" and row["sd_ok"] == "" and row["armed"] == ""
    assert row["vbat_v"] == ""

    # Binary frames are unchanged: all four flags reported, vbat is a number.
    w = telemetry_to_wire(t, host_time_ms=1_700_000_000_000)
    assert w["flags_known"] == packet.FLAGS_ALL and w["vbat_v"] == 0.0


def test_csv_unknown_health_cells_are_empty() -> None:
    """PROTOCOL.md: a 0 in hw_* means the peripheral is DOWN. So an unknown bit
    has to be written empty, or the post-flight record gains failures that never
    happened."""
    t = packet.Telemetry(seq=1, health=packet.HEALTH_BARO)
    row = t.to_csv_row("2026-08-19T00:00:00.000+00:00",
                       health_known=packet.HEALTH_BARO | packet.HEALTH_IMU)
    assert row["hw_baro"] == 1
    assert row["hw_imu"] == 0              # reported, and reported down
    assert row["hw_sd"] == "" and row["hw_vbat"] == ""
    # Unchanged when the caller says nothing.
    assert t.to_csv_row("x")["hw_sd"] == 0


def test_mrcc_decodes_the_real_downlink() -> None:
    """A downlink line in the shape the bridge emits must land in the same
    Telemetry shape the binary codec produces, so everything downstream (loss,
    CSV, /ws, dashboard) stays identical between the two formats.

    This is the LONG-key spelling (GPSFIX/GALT/GSPEED/COURSE/STATE) with a fix
    filled in. NOTE the 2026-08-19 capture in flights/ used the later SHORT keys
    (GD/GF/GA/GS/ST) — mrcc.py aliases them, but nothing here asserts that."""
    body = ("MRCC,PKT=207,T=207.5,GPSDATA=1,GPSFIX=0,"
            "SAT=0,LAT=4.098600,LON=100.950500,GALT=45.0,GSPEED=0.00,COURSE=0.0,"
            "AX=0.00,AY=0.00,AZ=9.81,VX=0.00,VY=0.00,VZ=-3.50,ALT=120.0,HDG=103.5,"
            "P=101325,STATE=DESCENT")
    # `len=` is the receiver's payload-length field and mrcc.py validates against
    # it, so it is computed here rather than written by hand — a stale literal
    # would make this fixture a corrupt frame.
    line = f"len={len(body)} RSSI=-53 SNR=10.2 | {body}\n".encode()
    p = mrcc.MrccParser()
    frames = list(p.feed(line))
    assert len(frames) == 1 and p.parse_errors == 0

    t = frames[0].telemetry
    assert t.seq == 207 and t.onboard_ms == 207_500
    assert t.flight_state == FlightState.DROGUE       # MRCC "DESCENT"
    assert t.baro_alt_m == 120
    assert abs(t.vspeed_ms - (-3.5)) < 1e-9           # VZ m/s -> dm/s -> back
    assert abs(t.lat_deg - 4.0986) < 1e-6 and abs(t.lon_deg - 100.9505) < 1e-6
    assert t.gps_alt_m == 45 and t.gps_fix == GpsFix.NONE
    assert frames[0].link.rssi_dbm == -53 and frames[0].link.snr_db == 10.2

    # Fields with no protocol home are kept, not silently dropped.
    assert frames[0].extra["P"] == 101325 and frames[0].extra["HDG"] == 103.5

    # No battery in this revision -> vbat must read as unknown, never as flat.
    assert frames[0].has_battery is False
    _, known = mrcc.health_from_fields(frames[0])
    assert not known & packet.HEALTH_VBAT

    # Those surplus fields must survive all the way onto the wire, or they are
    # parsed-then-dropped — visibly present in the serial stream and visibly
    # absent from the screen, which reads as a broken ground station.
    w = telemetry_to_wire(t, host_time_ms=1_700_000_000_000,
                          rssi_dbm=frames[0].link.rssi_dbm,
                          snr_db=frames[0].link.snr_db,
                          extra=frames[0].extra)
    assert w["rssi_dbm"] == -53 and w["snr_db"] == 10.2
    assert w["extra"]["P"] == 101325 and w["extra"]["HDG"] == 103.5
    # Binary frames measure neither, and must say so rather than report 0 dBm.
    w = telemetry_to_wire(t, host_time_ms=1_700_000_000_000)
    assert w["rssi_dbm"] is None and w["snr_db"] is None and w["extra"] == {}


def test_mrcc_loss_tracking_matches_binary() -> None:
    """MRCC's PKT counter has to drive LossTracker exactly like `seq` does —
    that is the whole reason it is mapped onto Telemetry.seq."""
    p = mrcc.MrccParser()
    lt = LossTracker()
    stream = b"".join(
        f"MRCC,PKT={n},T={n}.5,AZ=9.81,ALT=0.0,P=101325,STATE=PAD\n".encode()
        for n in (10, 11, 14, 15)          # 12 and 13 lost
    )
    for frame in p.feed(stream):
        lt.observe(frame.telemetry.seq)
    assert lt.received == 4 and lt.lost == 2

    # PKT counts past a uint16; seq wraps, and the wrap must not look like loss.
    p2, lt2 = mrcc.MrccParser(), LossTracker()
    for n in (65535, 65536, 65537):
        for frame in p2.feed(f"MRCC,PKT={n},AZ=9.81,STATE=PAD\n".encode()):
            lt2.observe(frame.telemetry.seq)
    assert lt2.lost == 0 and lt2.resets == 0, (lt2.lost, lt2.resets)


def test_mrcc_ignores_chatter_but_counts_corruption() -> None:
    """The receiver sketch prints its own status lines. Those are not errors and
    must not inflate the count that tells the operator the link is degraded."""
    p = mrcc.MrccParser()
    frames = list(p.feed(b"=== RX BOOT ===\nRX ready\nalive 32046\n"))
    assert frames == [] and p.parse_errors == 0 and p.ignored == 3

    # A line cut in half mid-air IS the text link's version of a CRC failure.
    list(p.feed(b"MRCC,PK\n"))
    assert p.parse_errors == 1


def test_session_writes_and_raw_framing() -> None:
    t = packet.Telemetry(seq=1, flight_state=FlightState.PAD, onboard_ms=0,
                          baro_alt_m=0, vspeed_dms=0)
    with tempfile.TemporaryDirectory() as tmp:
        sw = SessionWriter(Path(tmp), {"kind": "test"})
        blob = b"\xAA\x55raw-bytes\x00\x01"
        sw.write_raw(1_700_000_000_000, blob)
        sw.write_row(t, 1_700_000_000_000)
        sw.write_event(t, 1_700_000_000_000)
        sw.close()

        raw = (sw.dir / "raw.log").read_bytes()
        host_ms, n = _RAW_HEADER.unpack(raw[:_RAW_HEADER.size])
        body = raw[_RAW_HEADER.size:_RAW_HEADER.size + n]
        assert host_ms == 1_700_000_000_000 and n == len(blob) and body == blob

        header = (sw.dir / "telemetry.csv").read_text().splitlines()[0]
        assert header.split(",") == packet.CSV_COLUMNS
        assert (sw.dir / "metadata.json").exists()
        assert "landed" not in (sw.dir / "events.csv").read_text()  # PAD isn't labeled landed


def test_mrcc_csv_columns_extend_the_protocol_contract() -> None:
    """MRCC's extra columns may only ever be APPENDED to packet.CSV_COLUMNS.

    Every existing reader (the PLDR notebook, any pandas load, the export in the
    dashboard's Settings view) is positional-or-named against that prefix. Adding
    a column in the middle would silently shift a flight's worth of data one cell
    to the left, which is the kind of corruption nobody notices until analysis.
    """
    assert mrcc.CSV_COLUMNS[:len(packet.CSV_COLUMNS)] == packet.CSV_COLUMNS
    added = mrcc.CSV_COLUMNS[len(packet.CSV_COLUMNS):]
    assert added[:2] == ["rssi_dbm", "snr_db"]
    assert added[-1] == mrcc.EXTRA_COLUMN
    assert len(set(mrcc.CSV_COLUMNS)) == len(mrcc.CSV_COLUMNS)  # no collisions

    # A field the codec already consumes must NOT also get an aux column, or it
    # is empty in every row of every flight.
    for name in mrcc.AUX_FIELDS:
        assert name not in mrcc._CONSUMED, name


def test_mrcc_aux_row_records_what_the_screen_shows() -> None:
    """The Aux strip's fields have to survive into telemetry.csv.

    Regression guard for the actual bug: these were parsed, broadcast, drawn, and
    then dropped at the only step that outlives the session.
    """
    body = ("MRCC,PKT=207,T=207.5,GD=1,GF=0,SAT=0,LAT=0.0,LON=0.0,GA=0.0,GS=1.25,"
            "CRS=90.0,AX=0.10,AY=-0.20,AZ=9.81,VX=0.00,VY=0.00,VZ=0.00,ALT=0.0,"
            "HDG=103.5,P=101325,ROLL=12.5,ST=PAD")
    line = f"len={len(body)} RSSI=-53 SNR=10.2 | {body}"
    frame = mrcc.decode_line(line)
    assert frame is not None

    row = mrcc.aux_csv_row(frame)
    assert set(row) <= set(mrcc.CSV_COLUMNS)                 # DictWriter would raise
    assert row["rssi_dbm"] == -53 and row["snr_db"] == 10.2
    assert row["aux_p"] == 101325 and row["aux_hdg"] == 103.5
    assert row["aux_gspeed"] == 1.25 and row["aux_course"] == 90.0   # short names resolved
    assert row["aux_az"] == 9.81 and row["aux_ax"] == 0.10

    # A key with no column of its own is kept, not dropped — the transmitter
    # renames fields between builds and the record must survive that.
    assert row[mrcc.EXTRA_COLUMN] == "ROLL=12.5"

    # A field this frame never carried reads EMPTY, never 0: aux_temp of 0 would
    # be a post-flight record claiming the airframe was at freezing point.
    assert row["aux_temp"] == "" and row["aux_gx"] == ""

    # Binary sessions keep the narrow contract, so nothing gains dead columns.
    assert "aux_p" not in packet.CSV_COLUMNS
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
