tan0607/avionics-ground-station/(commit log)

2026-07-05 docs: ground station plan + design specs
2026-07-05 feat(firmware): thin ESP32 GS bridge + AUX-disciplined E32 driver
    Target 1 of 2. Bridge holds the E32 in NORMAL mode and forwards the raw
    byte stream to USB serial untouched (parse/CRC stay on the laptop, so one
    parser owns the wire format and raw.log never misses a byte). LED pulses
    on each SYNC (0xAA 0x55) boundary.
    lib/E32 centralises the anti-lock-up rule: every UART write goes through
    writeFrame() -> waitAux(), and waitAux() has a timeout so a mis-wired AUX
    drops a frame instead of hard-stalling the loop. configure() programs +
    verifies 9600 UART / 2.4k air rate in CONFIG mode.
    PlatformIO, board=esp32dev. Wiring, modes, and AUX discipline in README.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
2026-07-05 feat(firmware): onboard 4 Hz telemetry TX + byte-verified packet mirror
    Target 2 of 2. onboard_tx (ESP32-S3) packs the shared 32-byte frame from a
    single read_sensors() seam and transmits at 4 Hz / 2.4k air rate over the
    E32. seq increments only on a successful write, so GS loss == RF loss; if
    AUX isn't HIGH within 200ms the frame is dropped (seq held) rather than
    stalling the flight loop -- the anti-lock-up rule, airborne.
    lib/TelemPacket is a header-only C mirror of shared/protocol/packet.py:
    #pragma pack(1) struct + static_assert(sizeof==28) + CRC-16/CCITT-FALSE.
    test/packet_check.cpp compiles on the host and proves it reproduces the
    Python reference frame byte-for-byte (aa5500..744e, cr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
2026-07-05 feat(dashboard): M1 ops-console — streaming altitude + status bar + readouts off mock
    Vite 8 + React 19 + TS (Tailwind v4 CSS-first, shadcn theme remapped onto
    console tokens, uPlot). Single-screen near-black instrument console per
    DESIGN_SPECS §3/§4: monospace tabular data, 1px hairline panels (no cards/
    shadows), semantic color only, calm-until-alarm.
    Data path (backend WS not built yet, so drive from mock):
    - lib/protocol.ts decoded-frame contract + tolerant normalizer; erasable
    const-object enums (mirrors shared/protocol/packet.py)
    - lib/mock.ts MockFlightSim — full PAD→…→LANDED flight, apogee ~1385 m,
    wind drift, seq-counted packe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
2026-07-06 feat(dashboard): M2 rework — monochrome mission console (admin shell, Geist, multi-sensor charts)
    Reshape M1's single-screen ops console into a shadcn admin-dashboard shell,
    then take it to a pure-black monochrome-terminal direction. Data layer is
    untouched: useTelemetry / mock / protocol / wsClient / UPlotChart unchanged.
    Shell:
    - SideNav thin left rail (Live active; Map/Log/Set placeholders, lucide)
    - TopBar mission id · T+ clock · link pill · loss% · source; alarm wash
    - KpiRow one segmented instrument strip (ALT/APOGEE/V-SPEED/TILT/VBAT/
    GPS) divided by 1px hairlines — not a card grid; calm-until-
    alarm tones (data white, semantic o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
2026-07-06 feat(pldr): flight-report notebook template + fake-flight fixture
    PLDR pipeline: point flight_report.ipynb at flights/<session>/ and Run All to
    get altitude/velocity/acceleration vs time, apogee + max-v + descent rates,
    GPS track + landing distance, an event timeline, and downlink loss % per phase.
    Reuses the SAME shared/protocol/packet.py codec for both logs: PacketParser
    decodes the binary SD master (full-rate) for kinematics; telemetry.csv (columns
    == packet.CSV_COLUMNS) drives seq-based link stats. to_csv_row() defines the
    shared schema so both paths converge on one table.
    make_fake_flight.py materialises a session folder from shared.fake_telemetry
    (SD log complete, downlink lossy with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
    [events.csv, telemetry.csv]
2026-07-06 feat(backend): serial->raw.log->csv->websocket + loss stats
    FastAPI ground station: pluggable byte source (--fake spawns
    shared.fake_telemetry; --serial reads the E32 bridge via pyserial) ->
    raw.log (host-timestamped, raw-first, replayable) -> PacketParser (imports
    shared.protocol.packet, never redefines the struct) -> telemetry.csv
    (packet.CSV_COLUMNS, flush/line) + events.csv (flight-state changes) ->
    native /ws broadcast of the exact dashboard WireFrame + last-frame replay
    on connect. Loss % from uint16 seq gaps (wrap-safe) at /stats. Serves the
    built dashboard at / so one :8000 origin runs UI + WS. Offline self-tests
    for loss/wire/raw-framing.
    Verified end-to-end with --fake: fast full-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
2026-07-07 feat(backend): --loop replays the fake flight for UI/demo work
    --fake plays one flight then the stream ends; watching it in the dashboard
    was a timing race. --loop respawns shared.fake_telemetry when it exits so
    there's always live data. seq restarts at 1 each loop -> LossTracker's
    RESET_GAP re-baselines, so replays don't inflate loss (verified: 59 loops,
    resets=58, loss_pct=0.0).
    [app.py, sources.py]
2026-07-07 feat(dashboard): offline PMTiles map — ground track + last-fix recovery readout
    Adds the Map view (GROUND_STATION_PLAN §5 / DESIGN_SPECS §2): a self-contained
    Leaflet + protomaps-leaflet panel that runs with the network fully disabled.
    - Basemap: launch-site region cut from a Protomaps daily build with go-pmtiles
    (vector PMTiles via HTTP range reads, NOT raster tile scraping — respects the
    OSM tile-usage policy). Bundled at dashboard/public/basemap.pmtiles (~8.6 MB,
    z0–15, ~20 km box around the pad).
    - FlightMap: protomaps "black" theme to match the monochrome console; live
    ground track, GS crosshair + link-state-colored vehicle marker, and the
    last-known coordinate shown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
2026-07-08 feat(dashboard): Log + Settings pages (event log, raw-frame table, prefs, export)
    Wire the two remaining SideNav views onto the frozen telemetry layer, plus a
    top-level README covering demo (mock / --fake) and live (--serial) usage.
    Log: useTelemetryLog piggybacks on the telemetry snapshot (same idiom as
    useSensorSeries) to build a capped newest-first raw-frame table + a derived
    mission event log (state transitions, pyro, link stale/restored, no-deploy,
    session reset). shadcn Table primitive re-themed to the console.
    Settings: useSettings (React Context + localStorage) drives connection/session
    status (polls /stats), a Web Audio alarm buzzer (useAlarmSound), display prefs
    (high-contrast su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
    [app.py]
2026-08-03 docs(design): rework layout spec to shadcn admin shell + anti-slop rules
    DESIGN_SPECS §3/§4: replace the split-pane sketch with the admin-dashboard
    shell (left nav + top bar + KPI card row + main chart + go/no-go panel), and
    tighten the visual rules — near-black surfaces, 1px hairlines, flat cards,
    semantic-only color, JetBrains Mono + tabular-nums.
2026-08-03 chore: track editor + MCP config, ignore machine-local codex hooks
    .vscode/c_cpp_properties.json gives the firmware C/C++ IntelliSense its
    include paths; .codex/config.toml is portable. .codex/hooks.json is not --
    it hardcodes an absolute $HOME skill path, same as .claude/settings.local.json.
2026-08-03 feat(protocol): per-peripheral health byte replaces reserved
    BODY byte 29 was an always-zero reserved byte; it now carries a HEALTH_*
    bitfield, one bit per peripheral (BARO/IMU/GPS/SD/PYRO/VBAT, 2 spare). Bit set
    = that device initialised and is currently responding.
    The point is that a peripheral failure must degrade ONE row on the ground
    station rather than collapsing the vehicle into a blanket 'AV FAILED' -- the
    operator needs to know which device died and which readouts to distrust.
    Free in air time: the byte already existed, so the frame stays 32 B / 128 B/s.
    packet_check.cpp is updated to the new reference frame (health 0x3F) and still
    proves the C mirror is byte-for-byte identical t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
2026-08-03 feat(firmware): fault isolation -- one dead peripheral is not a dead vehicle
    Fixes the cascade where a single failing component takes the whole flight
    computer with it.
    Two mechanisms were responsible:
    1. Init failure aborting boot. read_sensors() was called unguarded inside the
    4 Hz cadence and nothing bounded a peripheral's setup. lib/Subsystem now
    tries every init() exactly once, records failures, and continues -- there is
    no 'while (1)' in that path. A board with all six devices dead still boots
    and still downlinks, reporting all six dead.
    2. A wedged I2C slave hanging the shared bus. A part that browns out mid-
    transfer holds SDA low, which is indistinguishable from 'b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
2026-08-03 feat(gs): name the failed peripheral instead of a blanket AV failure
    Backend ships the health byte, per-peripheral hw_* booleans, and a
    failed_subsystems list; CSV gains hw_* columns so post-flight analysis can
    distinguish 'altitude went flat because the baro died at T+14' from 'the
    rocket stopped climbing'.
    New SubsystemHealth panel renders one row per peripheral with the consequence
    spelled out ('Stale: Altitude'), so the operator knows which readouts to
    distrust rather than being told the vehicle failed.
    A frame with no health byte (pre-health firmware, old raw.log replay) is
    treated as UNKNOWN, not as all-failed -- six red alarms for a missing field
    would be a false alarm. wire contrac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
    [tests.py, wire.py]
2026-08-03 feat(firmware): standalone Arduino-IDE receiver that decodes, not just forwards
    bridge.cpp stays deliberately dumb -- raw passthrough, one parser on the laptop.
    That is right for the real data path and useless on a bench with no laptop, where
    the only question is "is anything arriving, and is it intact?"
    arduino/E32Receiver answers that on its own: SYNC hunt, CRC-16 check, all 15
    fields unpacked into aligned columns, and a link summary that separates CRC
    errors from silence -- errors mean RF is arriving damaged, silence means a
    channel/air-rate mismatch. Different faults, different fixes.
    Runs on the Uno bench setup today and the ESP32 later from one source. lib/E32
    could not be reused: it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
2026-08-03 fix(editor): make IntelliSense resolve the firmware instead of guessing
    Every firmware file was solid red. The tracked .vscode/c_cpp_properties.json
    pointed compilerPath at /usr/bin/clang and includePath at ~/Library/Arduino15 --
    host clang, plus a directory that does not exist on this machine. Nothing in it
    knew what Arduino.h, millis(), or String were, so cpptools flagged all of it.
    PlatformIO generates the correct config itself (real xtensa toolchain, ~460
    framework include paths) but only once the platform packages are installed and
    only when platformio.ini sits at a workspace root -- neither was true. Hence the
    .code-workspace listing firmware/ as its own root.
    The generated c_cpp_pro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
2026-08-03 chore: untrack flights/ — the ignore rule never applied to it
    .gitignore has had `flights/` since the rule was written, but these five files
    were committed before it, and gitignore does not apply to already-tracked files.
    So per-run session data kept getting versioned while the repo looked like it was
    excluding it — and it is now public.
    This capture is simulated (shared/fake_telemetry.py), so nothing sensitive
    leaked. The point is that the next one would have been real, and would have gone
    the same way. Files stay on disk; only the tracking stops.
    [events.csv, telemetry.csv]
2026-08-03 feat(firmware): raw-byte mode, self-test, and a PlatformIO path for the sketch
    Three gaps found while actually booting this on a Uno.
    A strict decoder cannot distinguish "no RF" from "RF I refuse to parse". The
    sketch only prints 32-byte AA-55 frames that pass CRC, so a partner transmitting
    plain text is received perfectly and silently dropped -- on screen, identical to
    a dead radio. Raw byte counting now runs alongside frame counting, and the stats
    line says so outright when bytes arrive but nothing ever matches. -DE32_SHOW_RAW
    dumps hex + ASCII to show what the other end is really sending.
    E32_SELFTEST pushes two frames generated by packet.py through the identical
    feedByte() path before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
2026-08-03 fix(firmware): let E32_RUN_CONFIG be set from the build, and silence a warning
    Field debugging turned up a receiver that heard RF but demodulated nonsense:
    the module was not on factory defaults, so its air rate did not match the
    transmitter's and nothing could decode. E32_RUN_CONFIG is the escape hatch for
    exactly that, but it was a bare #define, so -DE32_RUN_CONFIG=1 collided with it
    and the in-file 0 won. Wrapped in #ifndef like the other two flags, so a one-off
    reprogram needs no source edit.
    runSelfTest() loses its `static`. The .ino preprocessor auto-generates a
    prototype for it even when E32_SELFTEST is 0 and the definition is compiled out;
    a static prototype with no definition warns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
2026-08-03 fix(firmware): show short bursts, and stop the warning that ate its own output
    Two defects found watching a real link fail on a bench.
    The raw dump only printed on a full 16-byte row, so a 5-byte burst sat in the
    buffer forever. The first few bytes off a marginal link are exactly the ones
    worth seeing, and they were the ones guaranteed never to appear. Partial lines
    now flush after 300 ms of quiet, hex columns padded so they still line up.
    The "RF arriving, no frame matched" notice reprinted every 5 s. Three lines of
    explanation on repeat buried the hex dump that actually diagnoses the problem,
    and the extra serial traffic starved SoftwareSerial of interrupts, corrupting
    the very output be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
2026-09-01 chore(firmware): snapshot the E32/binary-protocol firmware before replacing it
    This commit exists to be recoverable, not to be used. It captures the
    uncommitted SX1278 migration work AND four never-tracked directories
    (arduino/E32Hello, arduino/E32ReceiverSolo, arduino/E32Transmitter,
    lib/LoRaLink) that a plain delete would have destroyed with no history
    to fall back on.
    None of it is flown. The live link is MRCC ASCII text between a pair of
    Arduino sketches that lived outside this repo entirely; this tree speaks
    the 32-byte binary protocol at BW 125 kHz with hardware CRC off, while
    the real transmitter sends ~231 bytes of ASCII at BW 250 kHz with CRC
    on. Those two cannot hear each other, s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
2026-09-01 feat(firmware): replace the unflown binary firmware with the code that flies
    The repo held firmware nobody flashed while the firmware that actually
    flies lived on a Desktop folder with no version control. This swaps
    them.
    Out: a PlatformIO project (bridge.cpp, onboard_tx.cpp, lib/LoRaLink,
    lib/TelemPacket, lib/Subsystem, the arduino/ twins) speaking the 32-byte
    binary protocol at BW 125 kHz with hardware CRC off. The real vehicle
    sends ~231 bytes of ASCII MRCC at BW 250 kHz with CRC on, so those two
    could never hear each other -- bridge.cpp had never decoded the rocket it
    appeared to serve. Preserved in f735151, not lost.
    In: the two Arduino sketches that fly, 1010 files and 123 MB down to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
    [Baro.cpp, Baro.h, Config.h, Console.cpp, Console.h, Filters.cpp, Filters.h, Flight.cpp]
2026-09-01 feat(firmware): bring the host-side filter tools and SD_Doctor into the repo
    The last of the Desktop folder. `tools/` is what produces the report's
    before/after filter figures, and it earns its place next to the firmware
    rather than beside it: replay.cpp links MRCC_FlightComputer/src/Filters.cpp
    directly, so the graphs come from the same C++ that flies. Change a cutoff
    in Config.h and the figures move with it -- there is no Python reimplementation
    to drift out of step. The build script reaches the firmware through
    ../MRCC_FlightComputer/src, so tools/ has to stay its sibling; firmware/ is
    where that holds.
    SD_Doctor is a bench-only sketch for when the SD card will not mount: no
    radio, no se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
    [Arduino.h, SD_Doctor.ino, make_demo_log.py, plot_filters.py, replay.cpp]
2026-09-01 feat: flight recorder, flights portal, and aux telemetry readouts
    The working tree had accumulated a session's worth of shipped work. This
    lands it.
    Dashboard
    - Flights view + useRecordedFlights: a persistent archive of the
    operator-declared flights the REC button cuts, so a flight can be
    found and inspected after the session that recorded it has ended.
    - useFlightRecorder: the REC side of that, cutting flight-NN_<name>/
    out of the running session.
    - AuxReadouts: the MRCC fields with no home in the Telemetry struct
    (pressure, heading, ground speed, horizontal accel/velocity). They
    ride on the frame in `extra` rather than being dropped, so surfacing
    them was a U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
2026-09-01 feat(firmware): switch the ground station's channel at runtime
    One receiver box can now cover both rockets across a launch day. A and B
    on the serial monitor retune it; ? reports the current channel, packet
    count and last RSSI/SNR. Both airframes can sit powered on the pad at
    once -- separate channels, so they never collide -- and you fly one,
    press a key, and fly the other. No reflash, no reboot, and the backend's
    serial connection survives it. VEHICLE is now only the power-on default.
    Two details in the switch are load-bearing, both about racing the radio:
    onReceive(NULL) first. handleDio0Rise() runs in ISR context and does
    its own SPI (IRQ flags, payload length, FIFO pointer) before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
    [MRCC_GroundStation.ino]
2026-09-01 fix(dashboard): restore LANDED_TAIL_S and drop the debug global
    3587c35 was cut while the landing-freeze behaviour was still being
    verified, so it captured the test scaffolding rather than the shipping
    values: LANDED_TAIL_S at 2 (the value that makes the freeze observable
    inside the mock's 8 s LANDED hold, not the 10 s the comment describes),
    and a line hanging the uPlot instance off `window.__altPlot` from inside
    the apogee draw hook.
    The probe was a measurement tool — reading u.scales.x.min directly was
    the only way to prove the window anchors at liftoff and holds at
    touchdown — but it leaks a live chart instance onto the global object on
    every frame, which is not something to ship.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
2026-09-01 feat(firmware): switch the ground station's channel from the BOOT button
    The serial commands needed a laptop with a monitor open, which is the
    wrong thing to need standing at a pad. BOOT now steps to the next
    channel and the onboard LED answers: one blink for A, two for B. Between
    switches the LED pulses per packet, so link-alive is readable across a
    field. No extra hardware -- both are already on the DevKit.
    GPIO0 is safe to poll despite being half the auto-reset circuit
    (RTS->EN, DTR->GPIO0): backend/sources.py::_reset_board sets dtr=False
    and leaves it there for the life of the connection, so GPIO0 stays
    released on its pull-up. Checked before relying on it, because a held
    DTR would have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
    [MRCC_GroundStation.ino, plot_filters.py]
2026-09-01 feat: switch the ground station's channel from the dashboard
    Set -> Radio Channel now carries the same A/B switch the receiver takes
    on its serial port, so the channel can be changed from the laptop with
    no serial monitor open. The firmware needed nothing -- it already reads
    those keys.
    The console never draws a channel it merely asked for. POST /gs/channel
    sends the key and deliberately reports nothing back; ChannelWatcher
    reads the real channel out of the box's own announcements (boot banner,
    switch marker, '?' status) as they pass through ingest, and GET /gs
    serves that. A command written but never acted on therefore shows up as
    the channel not changing, which is the truth. It stays null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
2026-09-01 refactor(firmware): drop the BOOT-button channel switch
    The dashboard control landed and covers the case; a physical button on
    the receiver was a second way to do the same thing, and the second way
    is the one that has to justify itself. Gone: handleButton, PIN_BTN, the
    debounce constant, and the identify blink whose whole purpose was
    confirming a press without a laptop.
    Kept, and neither is about the button:
    NVS persistence. Attaching the backend RESETS this board on purpose
    (sources.py::_reset_board, for a known state and a boot banner), so
    without it every reconnect would silently drag the box back to the
    compile-time default -- switch to B on the console, the laptop
    reconnects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
    [MRCC_GroundStation.ino]
2026-09-01 fix(backend): restart loss counters when the ground station changes channel
    Loss counts a link, and a channel switch IS a new link. The two rockets
    number their packets independently, so carrying the counters across
    produced a figure about neither vehicle: a seq jump under LossTracker's
    RESET_GAP (1000) was booked as hundreds of losses that were never sent,
    and a jump over it re-baselined but left the first rocket's history in
    the denominator for the rest of the session. There was no reset path at
    all -- LossTracker is built once in Runtime.__init__ -- and cutting a
    flight with REC does not help, since that only cuts a folder.
    ChannelWatcher.feed now reports a switch, and ingest restarts th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
    [app.py, session.py]
2026-09-02 feat(dashboard): error cards with the fix, bottom-right
    "Something is wrong" tells an operator nothing the blank screen did not
    already. The failures this console actually sees have specific, boring
    causes -- the Arduino Serial Monitor is holding the port, the cable moved
    to another USB socket and the device got renamed, the backend was stopped
    -- and each has one action. So every alert carries the action, and a
    command to run where one exists, copyable.
    Derived fresh from live state rather than queued as events, so a card
    clears the moment its cause does. A queue would keep "port busy" on
    screen after the port was freed, and an operator cannot tell a stale
    warning from a live one at a glan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
2026-09-02 docs(readme): lead with the first run, and fix what had drifted
    The README opened with architecture and did not say what to do with a
    fresh clone until a third of the way down, under a "Prerequisites"
    heading that only listed two tools. Someone handed this repo had to read
    past the wire formats and the two-rocket channel scheme before finding
    the one command that runs it.
    Now it opens with Start here: install two things, run one command with
    no hardware, and a description of what a working console looks like so a
    first run can be judged. The demo mode leads, because it is the one path
    that works before any board exists.
    Added the four things a clone does not contain -- .venv, node_modules,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
2026-09-03 fix(dashboard): make the backend alert's command readable and current
    The "Backend is not answering" card offered `backend/.venv/bin/python -m
    backend.app --serial /dev/tty.usbserial-XXXX`, which is how the backend
    was started before start.command existed. It is also 76 characters in a
    320px card, so it rendered as "backend/.venv/bin/python -m backend.app
    …" -- the flags, the placeholder port, and the fact that the port WAS a
    placeholder all fell off the edge.
    The command is now ./start.command, and the fix text says to run it from
    the repo root and mentions --demo, the path that works with no receiver
    plugged in. That is the first move now whether the backend crashed or was
    never started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
2026-09-03 chore(vscode): stop IntelliSense reporting errors the builds never see
    Three files were red in the editor while compiling clean on the command
    line, for three unrelated reasons.
    c_cpp_properties.json -- each board configuration needs TWO include
    trees, not one. cores/esp32/Arduino.h includes "freertos/FreeRTOS.h",
    which is not in the core at all; it lives in the per-chip ESP-IDF bundle
    under tools/esp32<chip>-libs/. Without that tree every file including
    <Arduino.h> reported "cannot open source file", which is most of the
    firmware. sdkconfig.h is the fiddly one -- not under that bundle's
    include/ but in a sibling directory per flash/PSRAM mode. These point at
    qio_qspi, the generic dev-modul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
2026-09-04 fix(firmware): an IMU that answers is not an IMU that is working
    imuOK was answering two different questions. Everything that read it
    meant "samples are arriving"; initIMU() only ever proved "the chip
    acknowledges begin()". The ICM keeps doing the second long after it
    has stopped doing the first.
    initIMU() also stamped lastImuUpdate, so each retry handed a silent
    sensor a fresh staleness clock. serviceHealth() then printed
    [IMU] No data for 2 s - marking DOWN
    [IMU] *** RECOVERED *** (recovery #41)
    back to back every 5 s, forever, while the [SYS] line and the
    downlink both read IMU=OK. It reset the filter chain on every lap
    too. A climbing recovery counter was the only tell.
    Worse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
    [Health.cpp, MRCC_FlightComputer.ino, Sensors.cpp]
2026-09-04 feat(firmware): downlink the IMU health bit, and size the packet to LoRa's limit
    The packet carried SD= and BA= but nothing for the IMU, so the ground
    station had to guess it from AX/AY/AZ being non-zero. That guess was
    wrong in the one direction that matters: until the previous commit a
    dead IMU downlinked its last good sample forever, so the axes never
    read zero and the guess said OK straight through the failure. IM= is
    the flight computer's own imuOK, stated outright.
    No LORA bit, deliberately. serviceTelemetry() returns early when the
    radio is down, so the field could only ever be 1 in a packet that
    arrived. Silence is the honest link signal and the backend already
    reads it.
    Adding six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
    [MRCC_GroundStation.ino, Radio.cpp, Radio.h]
2026-09-04 fix(ground): read the fields the transmitter actually sends
    The transmitter renamed ALT to AL. mrcc.py looks every field up by
    name, so nothing errored - the key just landed in `extra` and
    baro_alt_m kept its default. The ground station showed 0 m altitude
    on a flying rocket with the real number sitting in raw.log. MX, AR
    and FI were lost the same way, never having had an alias at all.
    - alias AL -> ALT, so altitude decodes again
    - MX/AR/FI/SD/BA/IM get aux columns, appended so existing MRCC
    telemetry.csv files keep their column positions
    - health_from_fields prefers the vehicle-stated BA/IM over the
    P/axes proxies, falling back to them for older captures. The
    IMU proxy's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
    [app.py, tests.py]
2026-09-04 fix(firmware): set the ground reference before the first altitude sample
    A barometer reads altitude above sea level for a fixed SEA_LEVEL_HPA,
    so on the pad it reports the site elevation for the day's weather -
    tens or hundreds of metres, never 0. groundAlt is what turns that
    into "0 m on the pad", and it was primed in the FS_PAD block, which
    runs AFTER updateAltitude() in the same 20 Hz tick.
    So the first sample went through as raw MSL, and the alpha-beta
    filter read the correction on the next tick as a real 45 m drop in
    50 ms. Simulated against the shipped gains:
    t=0.00 alt +45.0 m vz 0.0 m/s
    t=0.25 alt 0.1 m vz -98.3 m/s
    t=0.50 alt -7.5 m vz -54.1 m/s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
    [Flight.cpp, Health.cpp, Storage.cpp]
2026-09-04 feat(firmware): GS_Doctor, a fault finder for a link that fails silently
    Almost every fault on this link looks identical from the operator's
    seat. Wrong frequency, wrong SF/BW/CR, wrong sync word, CRC off at
    one end, DIO0 in the wrong hole, or a rocket that is not switched on
    - all of them give you zero packets and no error message.
    MRCC_GroundStation prints "RX ready" and then says nothing for the
    rest of the day.
    This is SD_Doctor's twin for the receiver: it turns that one silence
    into distinguishable answers.
    1 radio present read path and write path SEPARATELY, because a
    dead MOSI passes a read test perfectly
    2 link parameters reset default -> after confi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
    [GS_Doctor.ino]
2026-09-04 feat(firmware): TX_Doctor, the half of the link GS_Doctor cannot see
    GS_Doctor can only tell you what does or does not arrive. Every fault
    on the rocket end is invisible to it: a modem configured wrong
    transmits perfectly on settings nothing is listening for, an unwired
    DIO0 lets telemetry keep flowing while every packet pays a timeout,
    and a supply that collapses mid-transmission looks like a crash.
    Test 3 is the one worth flashing for. Air time is a FINGERPRINT of
    the modem settings, so a stopwatch verifies SF and bandwidth with no
    receiver, no second person and no antenna range - and it catches what
    test 2 cannot, a register that reads back correctly while the modem
    does something else.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
    [MRCC_GroundStation.ino, TX_Doctor.ino]
2026-09-04 fix(firmware): TX_Doctor test 1 could not tell four failures apart
    Reported from the bench: the module has voltage on a multimeter and
    REG_VERSION does not read 0x12. Test 1 printed the byte and guessed
    at a cause, which is not enough - "0xFF" is the same byte whether
    MISO is on the wrong pin, SS is on the wrong pin, the jumper is
    unseated, or the bus cannot carry 8 MHz.
    Four things it now separates:
    - STATIC LINES, read before anything is clocked. MISO that does not
    react to chip select is not being driven by anything, and no
    amount of SPI will change that.
    - CLOCK RATE. On a failure it retries at 4/2/1/0.5/0.1 MHz. A module
    that answers at 500 kHz and not at 8 MHz has go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
    [TX_Doctor.ino]
2026-09-04 fix(firmware): TX_Doctor now separates a floating line from a held one
    Bench result: 0x00 at every clock from 8 MHz down to the 125 kHz
    bit-bang, and MISO reading 0 with SS both high and low. That rules
    out signal integrity and the SPI peripheral, and leaves four causes
    the sketch still could not tell apart - no power at the chip, a wrong
    pin, a short to ground, or a dead module.
    The static check could not help, because a disconnected ESP32 input
    and a line tied to ground both read 0.
    So probe each line against the internal pull-up and then the
    pull-down. The pull is ~45 kOhm, so anything actually driving the pin
    wins and a disconnected pin follows:
    up 1, down 0 FLOATING nothing i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
    [TX_Doctor.ino]
2026-09-04 fix(flight): stop the backup timer deploying before every apogee
    APOGEE_TIMEOUT was 12000 against a vehicle OpenRocket puts at apogee
    14.1 s after launch. The COAST block races the timer against the baro
    and takes whichever lands first, so a timeout set below apogee does not
    wait for a sensor failure - it pre-empts the working baro on EVERY
    flight.
    The charge would have gone at T+12 s, 2.1 s early, with the airframe
    still climbing at 20 m/s or better. Gravity alone accounts for that
    much; drag on the way up makes it worse. A chute out at that speed is
    a torn chute or a parted shock cord, which is the same recovery
    failure the timer exists to prevent.
    Nothing in the log would have looked wr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
    [Config.h]
2026-09-04 feat(flight): arm on the pad without a laptop
    The only way into FS_ARMED was the serial A key, which means a laptop
    at the pad. On this vehicle the USB port is also the supply, so the
    operator cannot arm and then walk away: unplugging resets the board,
    and initFlight() lands a reset back in PAD, disarmed, without saying
    so over the link.
    That is not a late deployment, it is no deployment. FS_PAD has no
    launch detector - the machine would sleep through the entire flight,
    logging and transmitting perfectly normal telemetry the whole way up,
    and the first sign of trouble would be the airframe arriving.
    So supply the keystroke nobody is there to press. FS_PAD now calls the
    same armFlight() the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
    [Config.h, Console.cpp, Flight.cpp]
2026-09-04 feat(firmware): PinForce drives the LoRa lines TX_Doctor can only watch
    TX_Doctor's line-state report reads each pin against the internal
    ~45 kOhm pull. That is enough to say a line is held, and not enough
    to say what is holding it -- anything wins against 45 kOhm.
    PinForce drives the pad instead, with ~40 mA behind it, and reads
    back what the pad actually reached. A line that still reads wrong
    under that is held hard: a dead S3 pad or a real short, not a module
    that merely fails to answer.
    Two things the passive test cannot do:
    - RST and NSS are covered here. TX_Doctor looks at MISO/SCK/MOSI/
    DIO0 only, and an RST held low parks the SX1278 in reset forever
    -- powered, wired, si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
    [PinForce.ino]
2026-09-04 fix(ground): ARMED decoded as PAD, so a live pyro bus read as safe
    The alert was right. Flight.cpp's stateName() has had FS_ARMED from
    the beginning and downlinks the word "ARMED". packet.FlightState
    never had it, so STATE_PREFIXES could not map it, and an unmapped
    phase word does not raise - decode_line falls back to PAD.
    So an armed vehicle reported itself as sitting safe on the pad while
    its pyro bus was live. Of the directions this could fail in, that is
    the worst one.
    - packet.FlightState gains ARMED = 7. APPENDED, not inserted at 1
    where it belongs chronologically: 0-6 are on the wire, in every
    telemetry.csv already written and in the PLDR notebook, and
    renumbering woul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
    [session.py, tests.py]
2026-09-04 fix(flight): say why the board is not auto-arming
    tryAutoArm() returned silently when the settle test failed. That was
    deliberate - the ordinary "not settled yet" refusal would otherwise
    print twenty times a second for the whole pad wait - but it recreated
    the failure auto arm exists to remove: a board that never arms and
    never says why.
    The case that makes it more than a logging nit is a scale or offset
    error. PAD_ACCEL_TOL is 0.5 m/s2 around gravity, on a part whose
    zero-g offset alone is specified at +-50 mg; the measured board sits
    at 9.70, which is inside with 0.34 to spare, but a part reading 9.1
    would fail the test forever while sitting perfectly still. Nothing
    about that looks like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
    [Config.h, Flight.cpp]
2026-09-04 fix(flight): let a live IMU veto a launch called on pressure alone
    The baro launch fallback said "in case the IMU died on the pad" and
    then never asked whether it had. Any pressure step past LAUNCH_ALT
    with vertVel over 5 m/s declared a launch, while a healthy IMU lying
    flat and reporting 1 g had no say in it.
    That matters on this range specifically. The vehicle sits ARMED on the
    rail for hours - the operator cannot go back to it once it is placed,
    and nine other rockets fly first. LAUNCH_ALT is 15 m, which is about
    1.8 hPa, well inside what a gust across imperfect static ports or a
    neighbouring motor can put on the sensor.
    A launch called there does not end in a late deployment. APOGEE_TI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
    [Flight.cpp]
2026-09-04 fix(baro): reject the 4000 m readings instead of flying on them
    readBaro() passed anything that was not zero or NaN. A1R has been seen
    reading 4000 m, which is about 616 hPa against a real 1010 - not drift
    and not noise, but a corrupted transfer arriving as a perfectly valid
    float, and the old check had no opinion about it.
    That is not a display problem. Fed to the alpha-beta filter a 4000 m
    step becomes thousands of m/s, and the sample that follows becomes
    thousands negative - APOGEE_VEL satisfied many times over. In COAST
    past MIN_ALT_GAIN, that is the charge. The same step also latches
    maxAlt, so MX stays wrong for the rest of the flight.
    Two vehicles run this firmware and only one does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
    [Baro.cpp, Baro.h, Config.h, Health.cpp]
2026-09-04 fix(baro): gate the spike on rate, not on distance per sample
    The gate landed as a fixed 40 m between samples, justified as 4x margin
    over a 200 m/s burnout at BARO_INTERVAL. That arithmetic assumed a
    50 ms sample interval, and nothing guarantees one.
    readBaro() is rate-LIMITED to BARO_INTERVAL, never rate-guaranteed. It
    runs when the loop reaches it, and the loop stalls - an SD write blocks
    for a hundred ms or more. The codebase already concedes this twice:
    Flight.cpp clamps its own dt at 0.5 s "or a stall", and serviceLogging()
    carries catch-up logic for the same reason.
    So a fixed distance tightens exactly when it must not. After a 200 ms
    stall the same 200 m/s moves the airframe those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
    [Baro.cpp, Baro.h, Config.h, Health.cpp]
2026-09-04 fix(baro): re-prime the altitude filter when the gate re-seeds
    The spike gate re-seeds after BARO_REJECT_RUN, on the assumption that a
    sensor which keeps saying the same new thing is either telling the truth
    or is broken past rejecting. That part is right. What it then did was
    publish the new value as an ordinary sample.
    Which handed updateAltitude() exactly the step the gate exists to keep
    out of it. The residual against a prediction built on the old altitude
    is the whole 4000 m; at FILTER_BETA over a 50 ms tick that is thousands
    of m/s into vertVel, and thousands negative on the sample after, when
    the prediction overshoots the other way. APOGEE_VEL is -2. In COAST past
    MIN_ALT_GAIN that i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
    [Baro.cpp, Flight.cpp, State.cpp, State.h]
2026-09-05 fix(firmware): TX_Doctor test 8 blamed the sensor for its own bad reads
    Test 8 read the BMP280's calibration and data registers with bare
    Wire.requestFrom() calls and never looked at what they returned. That is
    not a missing nicety. Wire.read() on an empty buffer returns -1, which
    lands in a uint8_t as 0xFF, so a short read did not fail - it fabricated
    all-ones data, ran it through the full Bosch compensation, and printed
    the result as a measurement. The verdict underneath then told the
    operator their sensor was out of range.
    On A1R that produced "temperature 187.8 C, pressure 1261.6 hPa, OUT OF
    RANGE - that is not weather, it is the sensor." Both numbers are exactly
    what an all-ones temper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
    [TX_Doctor.ino]
2026-09-05 fix(baro): take one conversion at a time, so the sensor stops resetting
    Measured on A1R with TX_Doctor test 8. The part accepts ctrl_meas 0x33,
    holds normal mode for about 150 ms, then loses the configuration
    outright: ctrl_meas reads back 0x00 and the data registers sit at
    0x80000, their power-on reset value. It is resetting. The same part runs
    the identical x8 conversion perfectly in forced mode, so the peak draw
    is fine and only the SUSTAINED draw is not.
    MODE_NORMAL at STANDBY_MS_1 with x8 pressure is very close to a 100%
    duty cycle - the highest continuous current this sensor can be asked to
    draw, and the setting this file happened to pick. Forced mode takes one
    sample per request and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
    [Baro.cpp, Baro.h, Config.h]
2026-09-05 fix(health): NO BARO warned on every healthy board and stayed quiet on a dead one
    printStatus() closed the `if (baroOK)` block before testing the spike
    count, so the else underneath was paired with baroSpikeCount rather than
    with the sensor. Both halves came out inverted.
    A clean board has zero spikes, so it took the else and printed
    "| NO BARO - apogee would be TIMER ONLY" on every status line it ever
    emitted. A board that had spiked took the if instead, and therefore
    never printed that warning at all - including with the barometer
    genuinely down, which is the one case it exists for.
    The comment above it reads "on a clean board this line never appears, so
    its presence is the whole message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
    [Health.cpp]
2026-09-05 test(firmware): lock down TX Doctor startup flow
2026-09-05 Confirm vehicle switches and remind operators to record flights
2026-09-05 Fix flight sensor sample freshness and vehicle B mounted tilt
    Consume fresh IMU and barometer evidence once, use actual barometer sample intervals, and derive vehicle B pad tilt from its confirmed +Y nose axis. Add host regressions and source-hashed validation reports; retain documented reset and pulse limitations.
    [Arduino.h, Flight.cpp, app.py, esp_system.h, main.cpp, test_ejection_simulation.py]
2026-09-05 feat(firmware): report auto-arm timer reset diagnostics
    [Flight.cpp, Flight.h, Health.cpp]
2026-09-06 feat: harden auto-arm and replay validation
2026-09-08 feat: harden reset recovery and validation workflows
    [Arduino.h, Baro.cpp, Baro.h, Config.h, Console.cpp, Console.h, Filters.cpp, Filters.h]
2026-09-09 fix: stop stranding the SD log descriptor across a remount
    Hardware reported `short write | base=243 expected=243 pending=0 |
    io_errno=9` on the first data row of a fresh file. errno 9 is EBADF and a
    genuine short write reports EIO, so the descriptor was already invalid
    before that row - the card was fine.
    Three defects produced and then misattributed it:
    - operator bool tested only fd_ >= 0, while write() short-circuits on the
    sticky error and returns 0 without touching the card. A handle that could
    no longer write still passed LogCheckpoint::append's guard, so a write
    that never happened was reported as a short one, carrying an errno left
    by an earlier, unrelated call.
    - size() w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
    [CheckedLogFile.h, Health.cpp, LogCheckpoint.h, Storage.cpp, checked_log_file_host.cpp, storage_checkpoint_host.cpp, test_storage_checkpoint.py]
2026-09-09 fix: mount SD at 4 MHz and say what EBADF means
    The dead-descriptor fix was flashed and the same line came back on
    FLIGHT015. The board was confirmed to be running it (the IDE build
    contains "append handle", a string only the new sources have), so the
    failure was traced instruction by instruction in that exact .elf:
    vfs_fat_write sees the descriptor's O_APPEND bit and calls
    f_lseek(file, f_size(file)) before f_write on every write
    -> f_lseek calls FatFs validate(), whose last check is
    ff_disk_status(pdrv) & STA_NOINIT (disassembly at 42023b6c)
    -> returns FRESULT 9 (FR_INVALID_OBJECT)
    -> fresult_to_errno maps 9 to errno 9 (4202627b)
    -> write() returns -1/EBADF, r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
    [Health.cpp, Storage.cpp, test_storage_checkpoint.py]
2026-09-09 feat: downlink binary telemetry at 10 Hz
    The ASCII key=value packet could not be sent at 10 Hz at any setting. At
    SF7 / BW250 / CR4-5 it measured 185-237 bytes, which is 149-187 ms of air:
    ONE copy is longer than a 100 ms window. Dropping SEND_INTERVAL alone
    would have left the TX state machine running late forever while the
    constant claimed 10 Hz - 5-6 Hz on the air, and nothing saying so.
    So the packet shrank instead. The same fields, re-encoded: LAT=%.5f spent
    13 bytes on a number that is exact in 4. 52 bytes base, 67 with both
    optional blocks, which is 51-62 ms and ~60% duty at 10 Hz - DOWN from the
    ~87% two ASCII copies plus COPY_GAP cost at 2 Hz. Field table and the
    reasoning for ever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
2026-09-09 fix: catch the barometer losing its configuration
    A1R's BMP280 does not fail quietly and does not fail noisily. Under a
    sagging supply it RESETS: ctrl_meas reads back 0x00 and the data registers
    sit at 0x80000, their power-on value, which compensates to about 616 hPa
    and publishes as a steady ~4000 m. It was seen again on the bench at
    17 dBm once the radio moved to a near-continuous duty cycle.
    Nothing in the firmware could see it:
    The absolute gate is 300-1100 hPa. 616 sits comfortably inside it.
    The rate gate catches the STEP, but only for BARO_REJECT_RUN samples -
    500 ms - and then concludes the sensor means it and re-seeds. That
    re-seed is right for a sensor that is merely off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
    [Baro.cpp, Baro.h, Health.cpp]
